rakhimgaliyev/vkrb/README.md

# vkrb
Выпускная квалификационная работа бакалавра
