rakhimgaliyev/vkrb/на печать/А3_НИР_d_26.pdf

# Ïàðåòî-ôðîíò îïòèìàëüíûõ ïàðàìåòðîâ êëàïàííîé ïðóæèíû ñ îãðàíè÷åíèì äèàìåòðà íàâèâêè ïðóæèíû d < 26 ìì

* Ñèíèì öâåòîì îáîçíà÷åíû âîçìîæíûå ðåøåíèÿ * Êðàñíûì - ôðîíò Ïàðåòî
* ×åðíûì - âûáðàííàÿ ïðóæèíà

Ðèñóíîê 3 - çàâèñèìîñòü êîëè÷åñòâà ðàáî÷èõ âèòêîâ îò êîýôôèöèåíòà çàïàñà

Ðèñóíîê 1 - çàâèñèìîñòü äëèíû ïðóæèíû â ñæàòîì ñîñòîÿíèè îò êîýôôèöèåíòà çàïàñà

Ðèñóíîê 2 - çàâèñèìîñòü ñðåäíåãî äèàìåòðà ïðóæèíû îò êîýôôèöèåíòà çàïàñà

# Ïàðåòî-ôðîíò îïòèìàëüíûõ ïàðàìåòðîâ êëàïàííîé ïðóæèíû ñ îãðàíè÷åíèì äèàìåòðà íàâèâêè ïðóæèíû d < 26 ìì

* Ñèíèì öâåòîì îáîçíà÷åíû âîçìîæíûå ðåøåíèÿ * Êðàñíûì - ôðîíò Ïàðåòî
* ×åðíûì - âûáðàííàÿ ïðóæèíà

Ðèñóíîê 3 - çàâèñèìîñòü êîëè÷åñòâà ðàáî÷èõ âèòêîâ îò êîýôôèöèåíòà çàïàñà

Ðèñóíîê 1 - çàâèñèìîñòü äëèíû ïðóæèíû â ñæàòîì ñîñòîÿíèè îò êîýôôèöèåíòà çàïàñà

Ðèñóíîê 2 - çàâèñèìîñòü ñðåäíåãî äèàìåòðà ïðóæèíû îò êîýôôèöèåíòà çàïàñà

КОМПАС-3D v18.1 Учебная версия © 2019 ООО "АСКОН-Системы проектирования", Россия. Все права защищены.
