rakhimgaliyev/vkrb/на печать/А3_НИР_Фронт_Парето.pdf

# Ïàðåòî-ôðîíò îïòèìàëüíûõ ïàðàìåòðîâ êëàïàííîé ïðóæèíû

# Ïàðåòî-ôðîíò îïòèìàëüíûõ ïàðàìåòðîâ êëàïàííîé ïðóæèíû

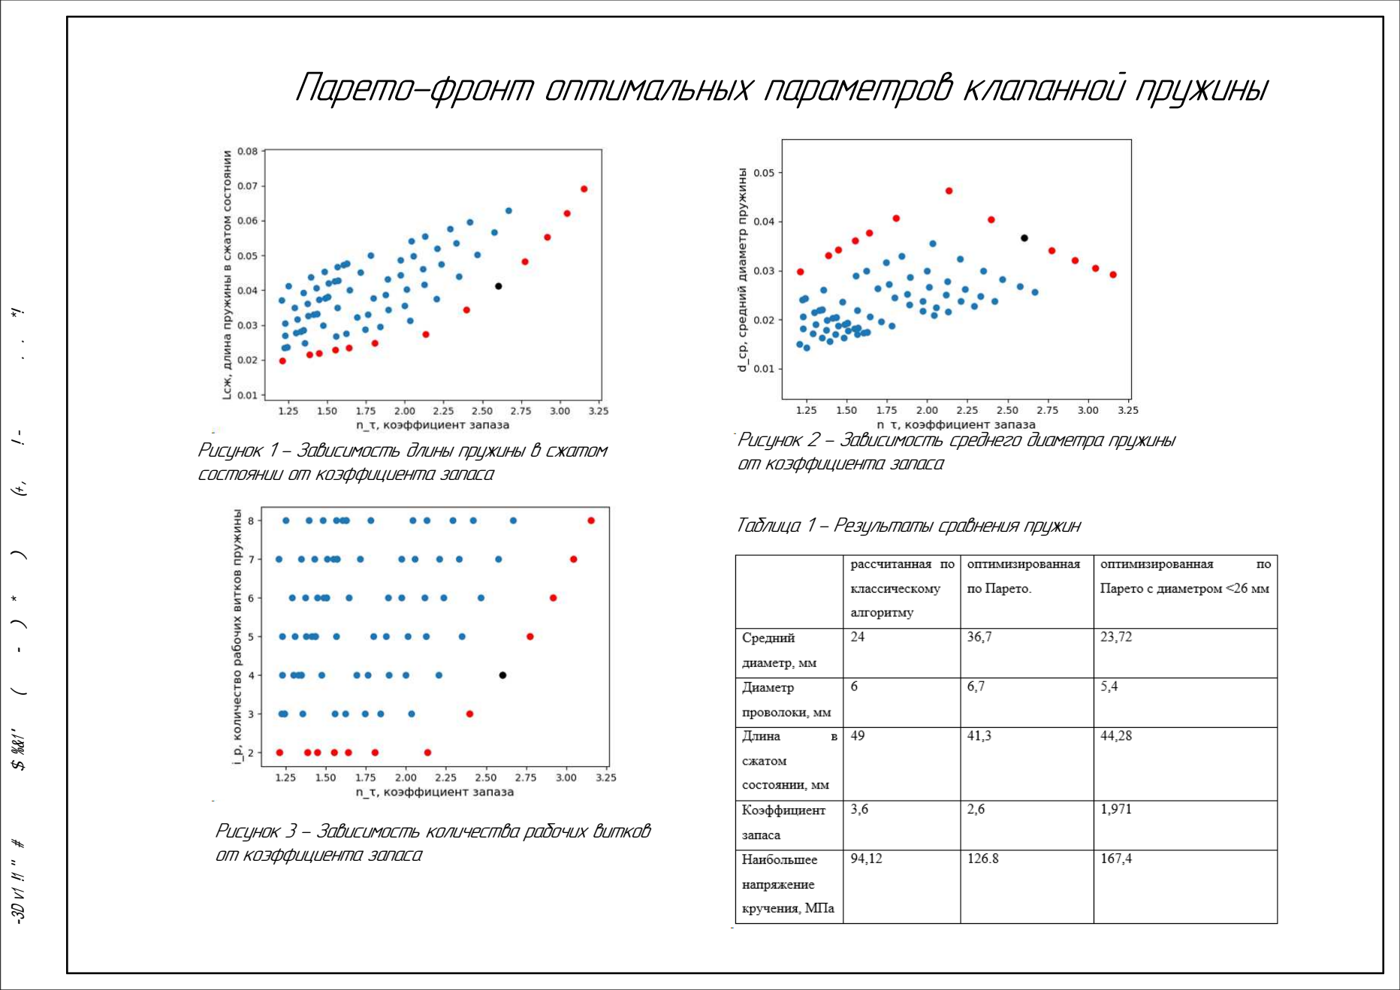
[picture p74: page 1]

Ðèñóíîê 3 - Çàâèñèìîñòü êîëè÷åñòâà ðàáî÷èõ âèòêîâ îò êîýôôèöèåíòà çàïàñà

Ðèñóíîê 1 - Çàâèñèìîñòü äëèíû ïðóæèíû â ñæàòîì ñîñòîÿíèè îò êîýôôèöèåíòà çàïàñà

Ðèñóíîê 2 - Çàâèñèìîñòü ñðåäíåãî äèàìåòðà ïðóæèíû îò êîýôôèöèåíòà çàïàñà

Òàáëèöà 1 - Ðåçóëüòàòû ñðàâíåíèÿ ïðóæèí

Ðèñóíîê 3 - Çàâèñèìîñòü êîëè÷åñòâà ðàáî÷èõ âèòêîâ îò êîýôôèöèåíòà çàïàñà

Ðèñóíîê 1 - Çàâèñèìîñòü äëèíû ïðóæèíû â ñæàòîì ñîñòîÿíèè îò êîýôôèöèåíòà çàïàñà

Ðèñóíîê 2 - Çàâèñèìîñòü ñðåäíåãî äèàìåòðà ïðóæèíû îò êîýôôèöèåíòà çàïàñà

Òàáëèöà 1 - Ðåçóëüòàòû ñðàâíåíèÿ ïðóæèí

КОМПАС-3D v18.1 Учебная версия © 2019 ООО "АСКОН-Системы проектирования", Россия. Все права защищены.
