rakhimgaliyev/vkrb/на печать/алгоритм оптимизации.pdf

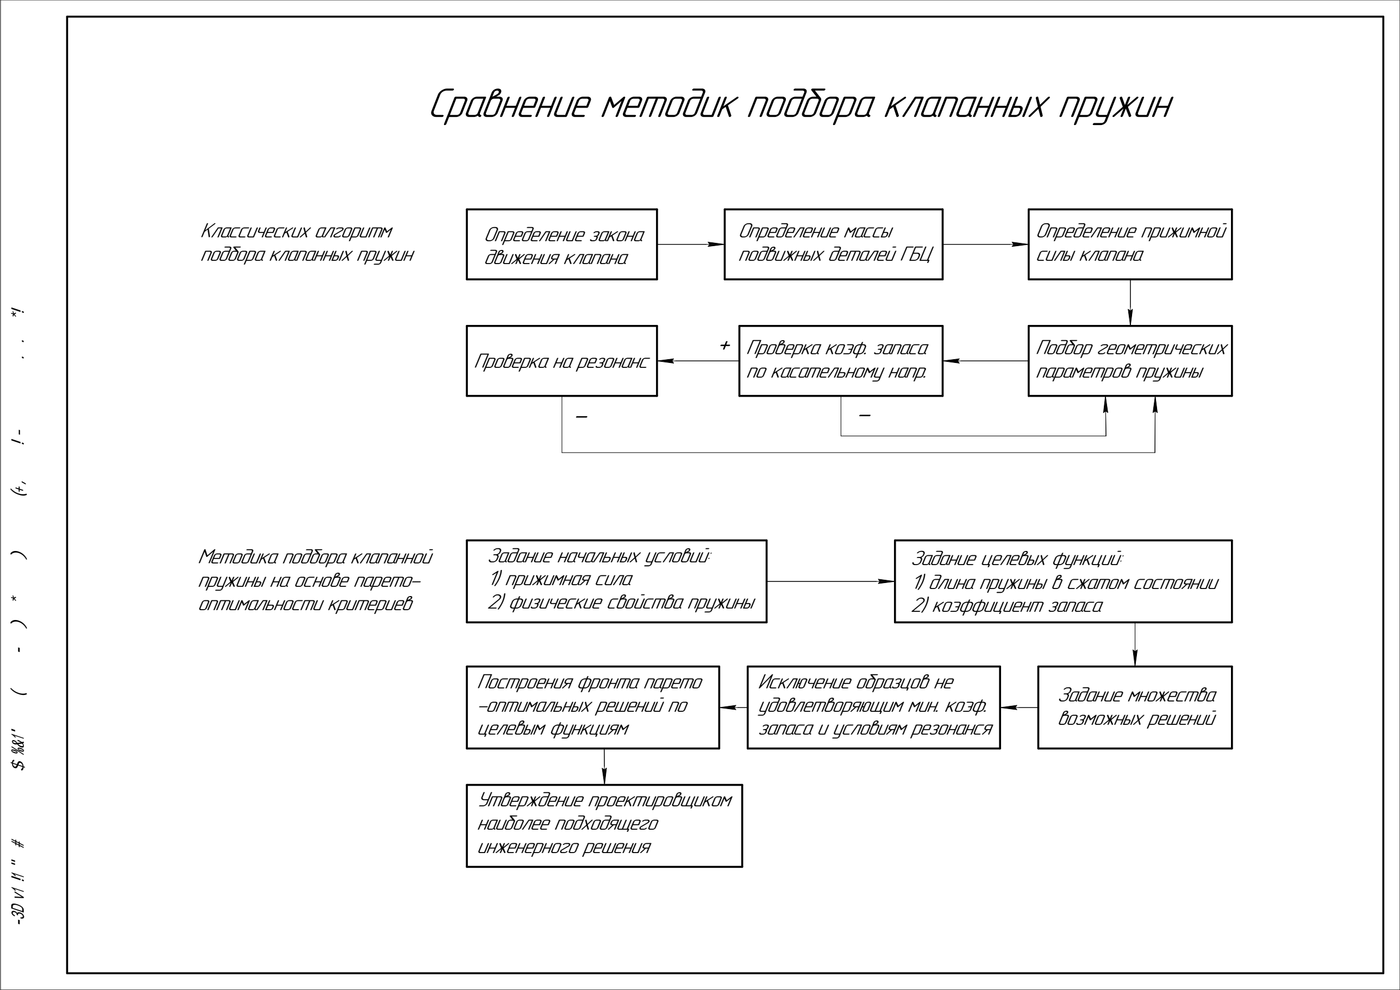
[picture p75: figure]
Çàäàíèå ìíîæåñòâà âîçìîæíûõ ðåøåíèé; Îïðåäåëåíèå çàêîíà äâèæåíèÿ êëàïàíà; Îïðåäåëåíèå ìàññû ïîäâèæíûõ äåòàëåé ÃÁÖ; Îïðåäåëåíèå ïðèæèìíîé ñèëû êëàïàíà; Êëàññè÷åñêèõ àëãîðèòì ïîäáîðà êëàïàííûõ ïðóæèí; Ìåòîäèêà ïîäáîðà êëàïàííîé ïðóæèíû íà îñíîâå ïàðåòî- îïòèìàëüíîñòè êðèòåðèåâ; Ïîäáîð ãåîìåòðè÷åñêèõ ïàðàìåòðîâ ïðóæèíû; Ïðîâåðêà êîýô. çàïàñà; - Çàäàíèå íà÷àëüíûõ óñëîâèé:; 1) ïðèæèìíàÿ ñèëà 2) ôèçè÷åñêèå ñâîéñòâà ïðóæèíû; Çàäàíèå öåëåâûõ ôóíêöèé: 1) äëèíà ïðóæèíû â ñæàòîì ñîñòîÿíèè 2) êîýôôèöèåíò çàïàñà; Èñêëþ÷åíèå îáðàçöîâ íå óäîâëåòâîðÿþùèì ìèí. êîýô. çàïàñà è óñëîâèÿì ðåçîíàíñÿ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

# Ñðàâíåíèå ìåòîäèê ïîäáîðà êëàïàííûõ ïðóæèí

ïî êàñàòåëüíîìó íàïð. Ïðîâåðêà íà ðåçîíàíñ

# Ñðàâíåíèå ìåòîäèê ïîäáîðà êëàïàííûõ ïðóæèí

ïî êàñàòåëüíîìó íàïð. Ïðîâåðêà íà ðåçîíàíñ

КОМПАС-3D v18.1 Учебная версия © 2019 ООО "АСКОН-Системы проектирования", Россия. Все права защищены.
