rakhimgaliyev/vkrb/на печать/10-А4_ЧБ_СПЕЦИФИКАЦИЯ.pdf

Âûïóñêíàÿ êâàëèôèêàöèîííàÿ ðàáîòà
Èçì. Ëèñò | | ¹ äîêóì. | Ïîäï. | Äàòà
| | Ðàçðàá. | Ðàõèìãàëèåâ | | Ñáîðêà áàëàíñèðíîãî âàëà | Ëèò. | Ëèñò | Ëèñòîâ
Ïðîâ. | Çåíêèí | | | | | | | 1

Í.êîíòð.
Óòâ.

ÌÃÒÓ èì. Í. Ý. Áàóìàíà
êàôåäðà Ý2
ãðóïïà Ý2-81Á

Èíâ. ¹ ïîäë. Ïîäï. è äàòà Âçàì. èíâ. ¹ Èíâ. ¹ äóáë. Ïîäï. è äàòà Ñïðàâ. ¹ Ïåðâ. ïðèìåí.
Äîêóìåíòàöèÿ

Ñáîðî÷íûé ÷åðòåæ

Äåòàëè

1 | Áàëàíñèðíûé âàë | 1
2 | Øåñòåðíÿ | 1

Ñòàíäàðòíûå èçäåëèÿ

3 | Ïîäøèïíèê 4024105 ÃÎÑÒ 4657-82 | 2
4 | Øàéáà ÃÎÑÒ 3248.5-16 | 1
5 | Áîëò Ì10õ40 ÃÎÑÒ 15589-70 | 1

Ôîðìàò
Çîíà
Ïîç.
Îáîçíà÷åíèå | Íàèìåíîâàíèå

Êîë.

Ïðèìå-
÷àíèå
Не для коммерческого использования | Êîïèðîâàë | Ôîðìàò | A4

КОМПАС-3D v18.1 Учебная версия © 2019 ООО "АСКОН-Системы проектирования", Россия. Все права защищены.
