rakhimgaliyev/vkrb/на печать/3_А1_ЦБ_КОЛЕНВАЛ.pdf

## Ðàñ÷åò íàïðÿæåííî-äåôîðìèðîâàííîãî ñîñòîÿíèÿ è çàïàñà öèêëè÷åñêîé ïðî÷íîñòè êîëåí÷àòîãî âàëà

Ãðàíè÷íûå óñëîâèÿ | Êîíå÷íî-ýëåìåíòíàÿ ìîäåëü ñáîðêè
Ïðè Zmax | Ïðè Zmin

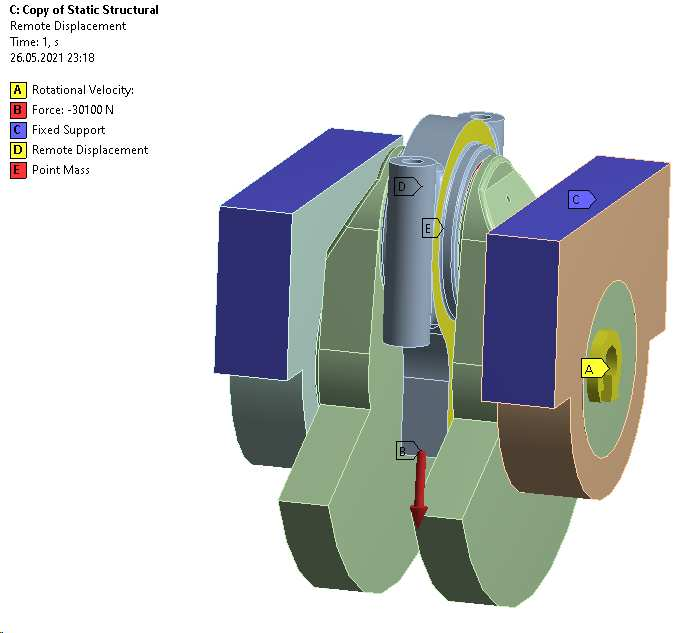
[picture p76: figure]
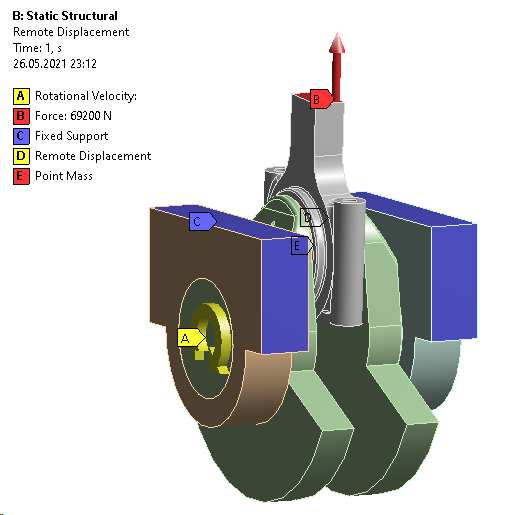
[picture p77: figure]

Ýêâèâàëåíòíûå íàïðÿæåíèÿ ïî Âàí-Ìåçèñó ïðè Zmax

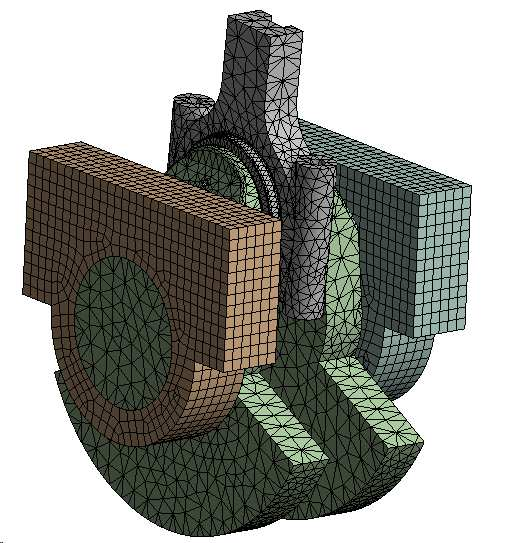
[picture p78: figure]

Ýêâèâàëåíòíûå íàïðÿæåíèÿ ïî Âàí-Ìåçèñó ïðè Zmin

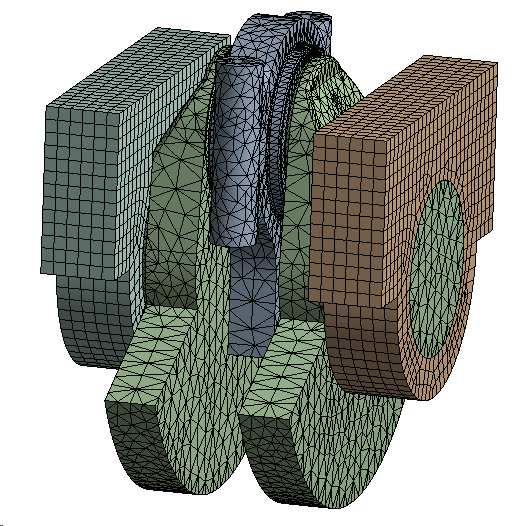
[picture p79: figure]

Ðàñïðåäåëåíèå êîýôèöèåíòà çàïàñà

Âû÷åñëåíèå êîýôèöèåíòà çàïàñà

n =

σ-1

σ1

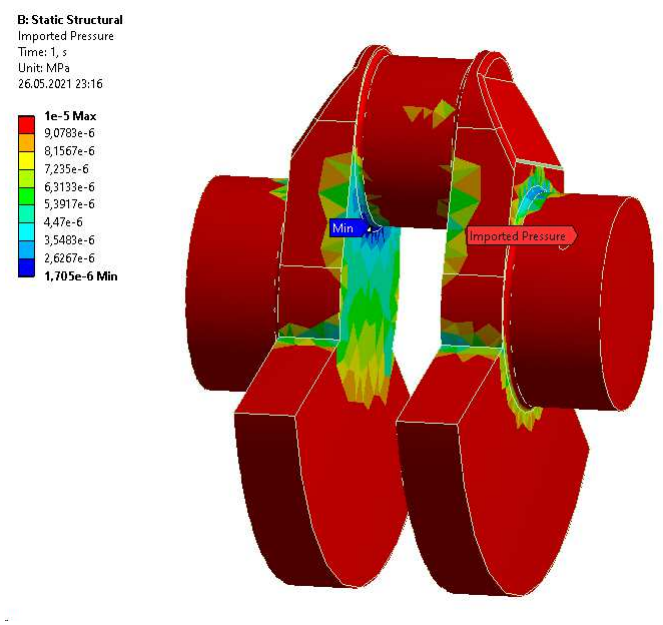
[picture p80: figure]
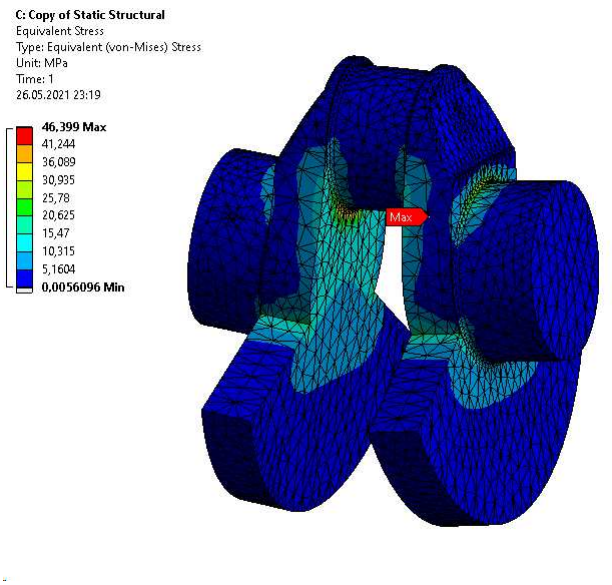
[picture p81: figure]
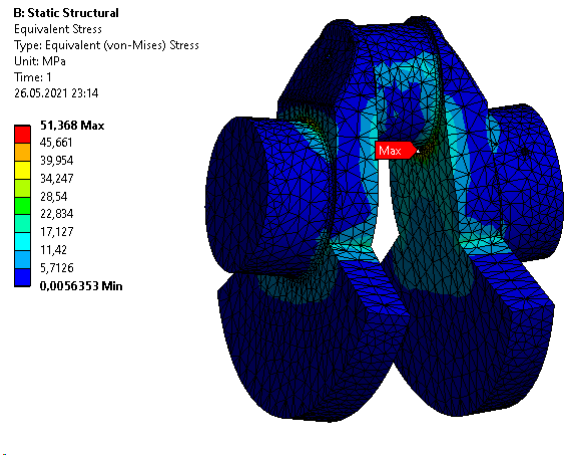
[picture p82: figure]

Âûâîä: Ìèíèìàëüíûé êîýôôèöèåíò çàïàñà n = 1,705. Ðàñ÷åò ïîêàçàë, ÷òî êîëåí÷àòûé âàë óäîâëåòâîðÿåò óñëîâèÿì ïðî÷íîñòè. Ìèíèìàëüíûé êîýôôèöèåíò çàïàñà ïðèíèìàåòñÿ èç äàïàçîíà 1,5 - 2,5.

## Ðàñ÷åò íàïðÿæåííî-äåôîðìèðîâàííîãî ñîñòîÿíèÿ è çàïàñà öèêëè÷åñêîé ïðî÷íîñòè êîëåí÷àòîãî âàëà

Ãðàíè÷íûå óñëîâèÿ | Êîíå÷íî-ýëåìåíòíàÿ ìîäåëü ñáîðêè
Ïðè Zmax | Ïðè Zmin

Ýêâèâàëåíòíûå íàïðÿæåíèÿ ïî Âàí-Ìåçèñó ïðè Zmax

Ýêâèâàëåíòíûå íàïðÿæåíèÿ ïî Âàí-Ìåçèñó ïðè Zmin

Ðàñïðåäåëåíèå êîýôèöèåíòà çàïàñà

Âû÷åñëåíèå êîýôèöèåíòà çàïàñà

n =

σ-1

σ1

Âûâîä: Ìèíèìàëüíûé êîýôôèöèåíò çàïàñà n = 1,705. Ðàñ÷åò ïîêàçàë, ÷òî êîëåí÷àòûé âàë óäîâëåòâîðÿåò óñëîâèÿì ïðî÷íîñòè. Ìèíèìàëüíûé êîýôôèöèåíò çàïàñà ïðèíèìàåòñÿ èç äàïàçîíà 1,5 - 2,5.

Í.êîíòð.
Óòâ.
| | | | Âûïóñêíàÿ êâàëèôèêàöèîííàÿ ðàáîòà
| | | | Ðàñ÷åò êîëåí÷àòîãî âàëà íà ïðî÷íîñòü | Ëèò. | Ìàññà | Ìàñøòàá
Èçì. Ëèñò | ¹ äîêóì. | Ïîäï. | Äàòà | | | | | 1:1
Ðàçðàá. | Ðàõèìãàëèåâ
Ïðîâ. | Çåíêèí
Ò.êîíòð. | | | | Ëèñò | Ëèñòîâ 1
| | | Äâèãàòåëü 4×Í 9,1/9,9 | ÌÃÒÓ èì. Í. Ý. Áàóìàíà êàôåäðà Ý2 Ãðóïïà Ý2-81á

Èíâ. ¹ ïîäë. Ïîäï. è äàòà Âçàì. èíâ. ¹ Èíâ. ¹ äóáë. Ïîäï. è äàòà Ñïðàâ. ¹ Ïåðâ. ïðèìåí.

Êîïèðîâàë | Ôîðìàò A1

КОМПАС-3D v18.1 Учебная версия © 2019 ООО "АСКОН-Системы проектирования", Россия. Все права защищены.
