rakhimgaliyev/vkrb/на печать/4_А1_ЦБ_ШАТУН_И_ПАЛЕЦ.pdf

# Ðàñ÷åò íàïðÿæåííî-äåôîðìèðîâàííîãî ñîñòîÿíèÿ

è

# çàïàñà öèêëè÷åñêîé ïðî÷íîñòè øàóòíà è ïîðøíåâîãî ïàëüöà

Ãðàíè÷íûå óñëîâèÿ | Êîíå÷íî-ýëåìåíòíàÿ ìîäåëü

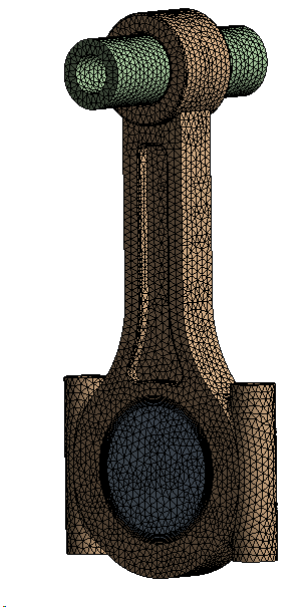
[picture p83: figure]

Ïðè Kmax | Ïðè Kmin

Ýêâèâàëåíòíûå íàïðÿæåíèÿ øàòóíà ïî Âàí-Ìåçèñó

Ïðè Kmax | Ïðè Kmin

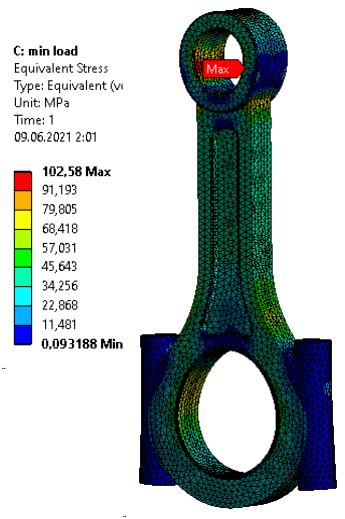
[picture p84: figure]
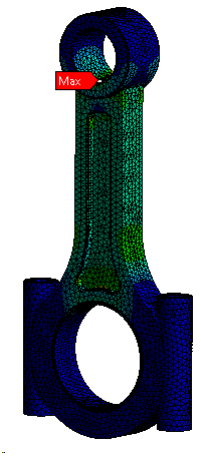
[picture p85: figure]
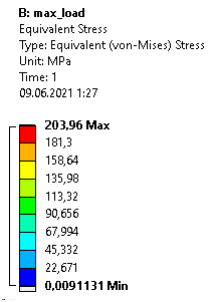
[picture p86: figure]

## Ðàñïðåäåëåíèå êîýôèöèåíòà çàïàñà

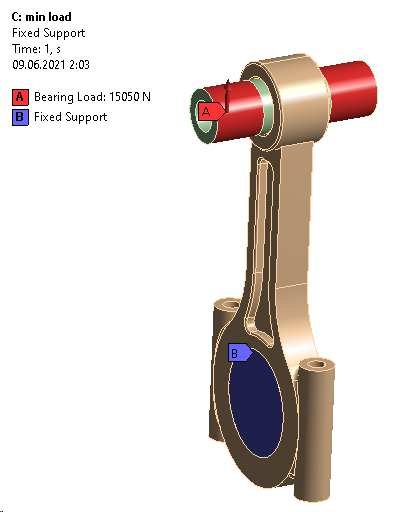
[picture p87: figure]
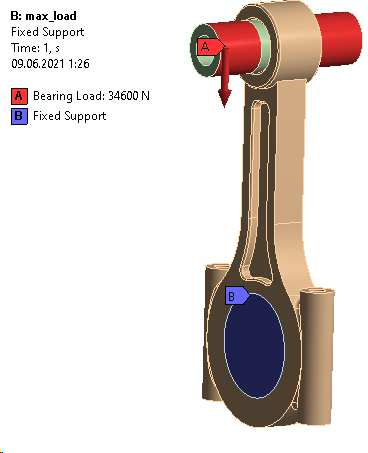
[picture p88: figure]

## Âû÷åñëåíèå êîýôèöèåíòà çàïàñà

n =

σ-1

σ1

## Ýêâèâàëåíòíûå íàïðÿæåíèÿ ïî Âàí-Ìåçèñó

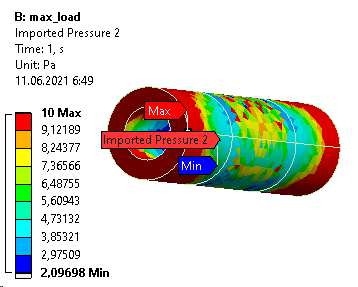
[picture p89: figure]

Ïðè Kmax | Ïðè Kmin

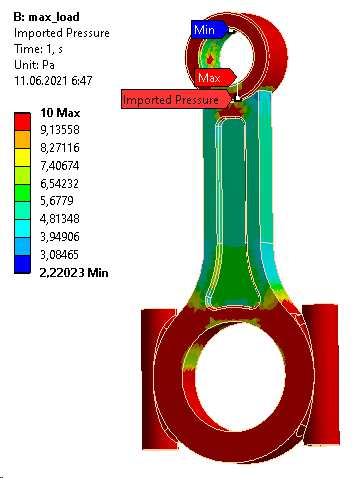
[picture p90: figure]
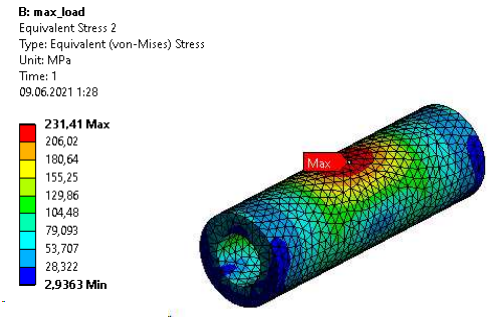
[picture p91: figure]
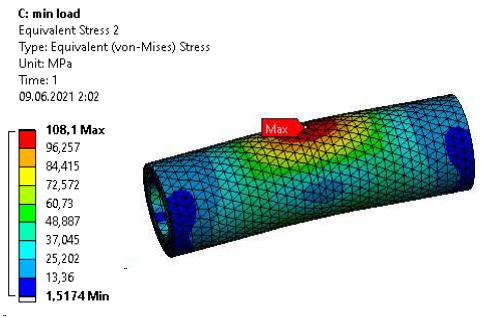
[picture p92: figure]

Âûâîä: Ìèíèìàëüíûé êîýôôèöèåíò çàïàñà øàòóíà n = 2,22, ïàëüöà n=2,1. Ïî çàïàñó öèêëè÷åñêîé ïðî÷íîñòè è ïî ìàêñèìàëüíûì íàïðÿæåíèÿì øàòóí è ïàëåö óäîâëåòâîðÿþò óñëîâèÿì ïðî÷íîñòè

# Ðàñ÷åò íàïðÿæåííî-äåôîðìèðîâàííîãî ñîñòîÿíèÿ

è

# çàïàñà öèêëè÷åñêîé ïðî÷íîñòè øàóòíà è ïîðøíåâîãî ïàëüöà

Ãðàíè÷íûå óñëîâèÿ | Êîíå÷íî-ýëåìåíòíàÿ ìîäåëü
Ïðè Kmax | Ïðè Kmin

Ýêâèâàëåíòíûå íàïðÿæåíèÿ øàòóíà ïî Âàí-Ìåçèñó

Ïðè Kmax | Ïðè Kmin

## Ðàñïðåäåëåíèå êîýôèöèåíòà çàïàñà

## Âû÷åñëåíèå êîýôèöèåíòà çàïàñà

n =

σ-1

σ1

## Ýêâèâàëåíòíûå íàïðÿæåíèÿ ïî Âàí-Ìåçèñó

Ïðè Kmax | Ïðè Kmin

Âûâîä: Ìèíèìàëüíûé êîýôôèöèåíò çàïàñà øàòóíà n = 2,22,
ïàëüöà n=2,1. Ïî çàïàñó öèêëè÷åñêîé ïðî÷íîñòè è ïî ìàêñèìàëüíûì
íàïðÿæåíèÿì øàòóí è ïàëåö óäîâëåòâîðÿþò óñëîâèÿì ïðî÷íîñòè | Ìàññà | Ìàñøòàá Èçì. Ëèñò | ¹ äîêóì. | Ïîäï. | Äàòà | Ëèò. Ðàçðàá.

Í.êîíòð.
Óòâ.

1:1
| Ðàõèìãàëèåâ
Ïðîâ. | Çåíêèí
Ò.êîíòð. | | | Ëèñò | Ëèñòîâ 1
| | Äâèãàòåëü 4×Í 9,1/9,9 | ÌÃÒÓ èì. Í. Ý. Áàóìàíà êàôåäðà Ý2 Ãðóïïà Ý2-81á
| Âûïóñêíàÿ êâàëèôèêàöèîííàÿ ðàáîòà
Ðàñ÷åò øàòóíà è ïîðøíåâîãî ïàëüöà íà ïðî÷íîñòü

Èíâ. ¹ ïîäë. Ïîäï. è äàòà Âçàì. èíâ. ¹ Èíâ. ¹ äóáë. Ïîäï. è äàòà Ñïðàâ. ¹ Ïåðâ. ïðèìåí.

Êîïèðîâàë | Ôîðìàò A1

КОМПАС-3D v18.1 Учебная версия © 2019 ООО "АСКОН-Системы проектирования", Россия. Все права защищены.
