rakhimgaliyev/vkrb/Mitsubishi MC - Engine 4D56 (1994 and subsequent). 1995-page-002.jpg

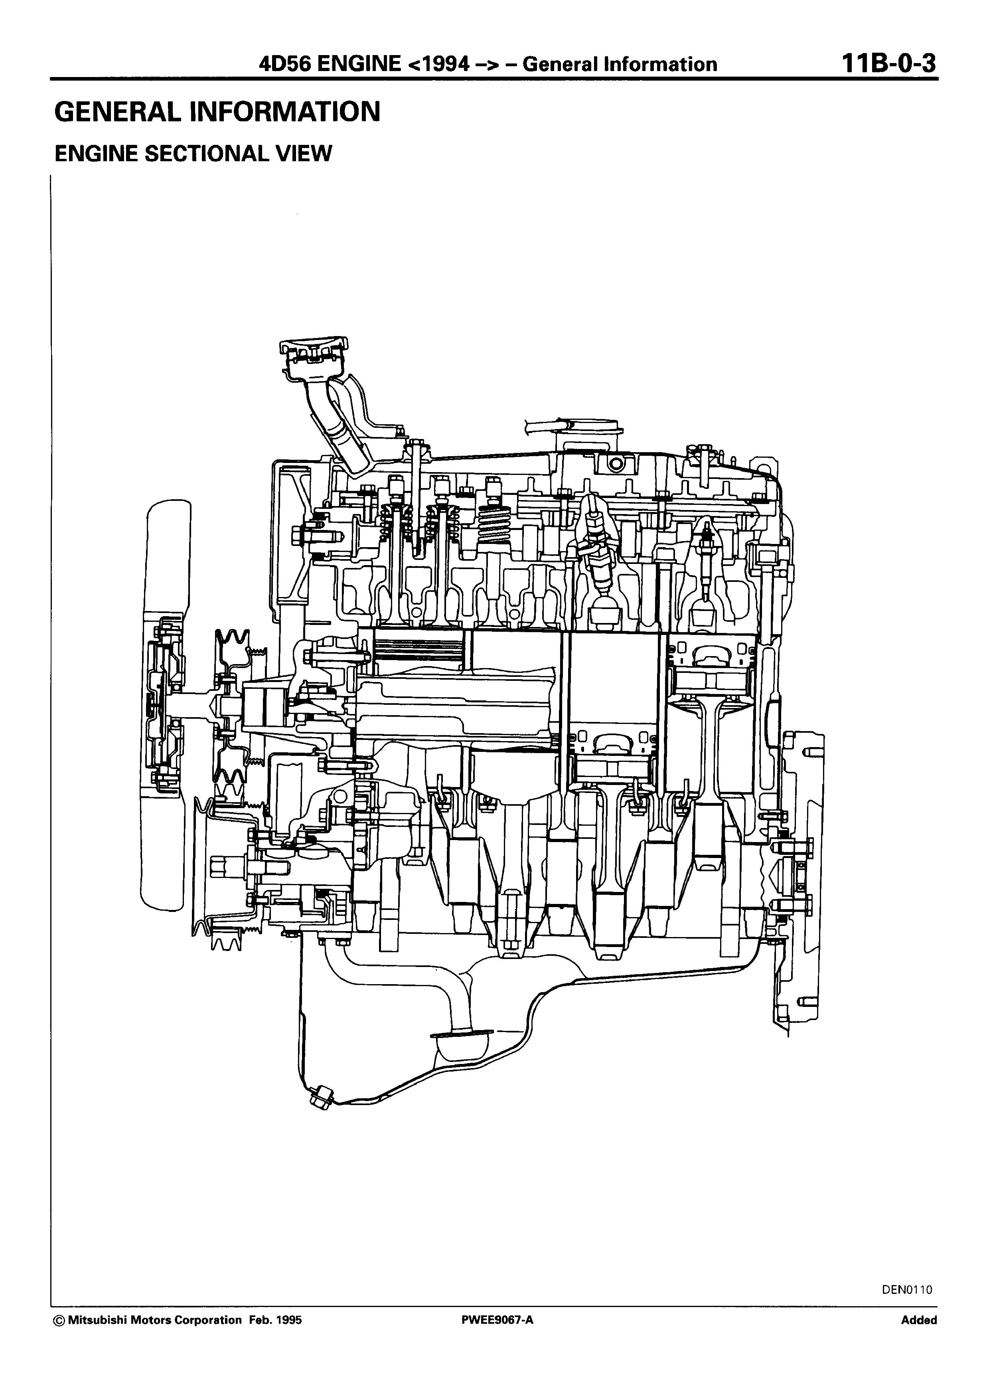
Mitsubishi MC - Engine 4D56 (1994 and subsequent). 1995-page-002.jpg
