rakhimgaliyev/vkrb/поршень/piston.igs

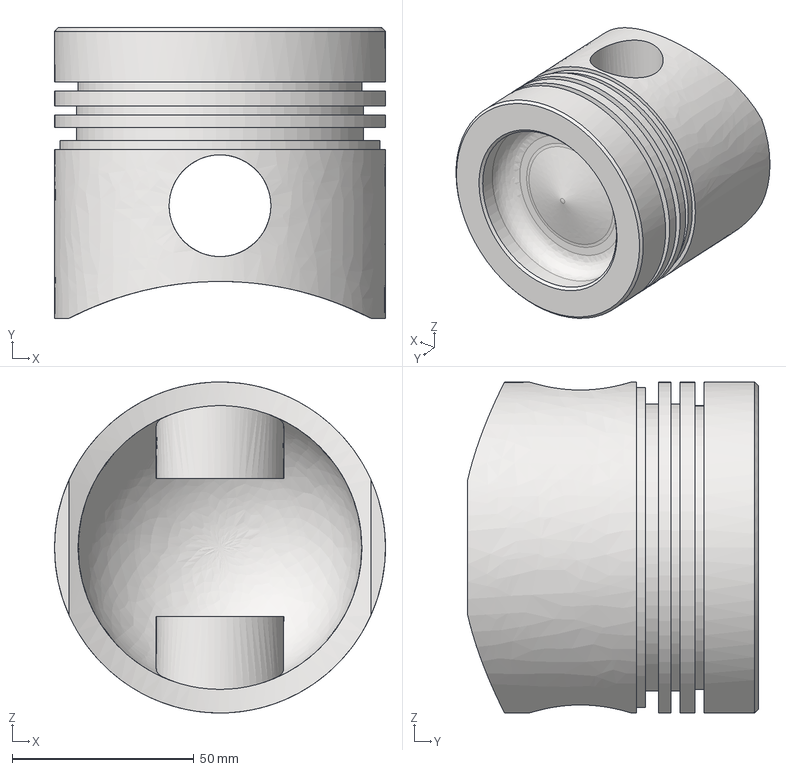
[picture p95: CAD file, 2021-06-11]
поршень/piston.igs
91.1 x 80.0 x 91.1 mm
