rakhimgaliyev/vkrb/расчет пружины/кулачек.SLDPRT

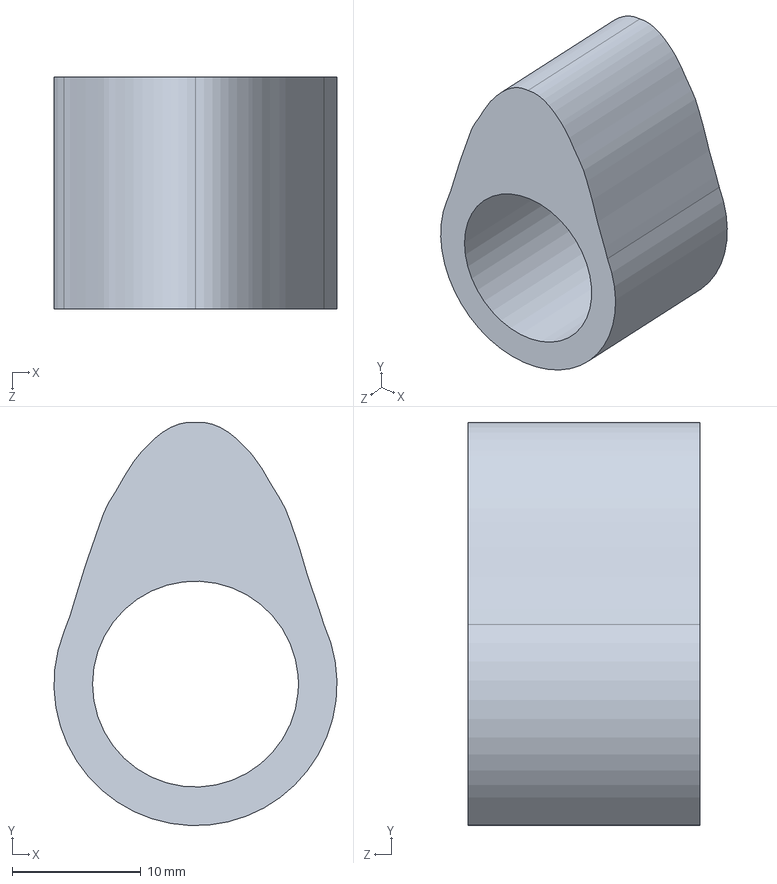
[picture p96: CAD file, 2021-06-06]
расчет пружины/кулачек.SLDPRT
22.0 x 31.3 x 18.0 mm
