rakhimgaliyev/vkrb/расчет пружины/клапан.SLDPRT

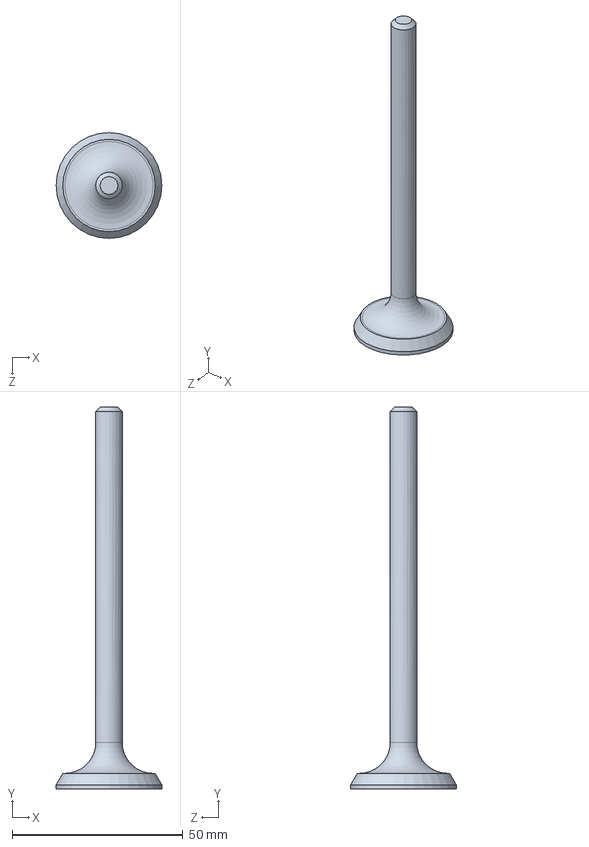
[picture p97: CAD file, 2021-06-06]
расчет пружины/клапан.SLDPRT
31.0 x 112.0 x 31.0 mm
