rakhimgaliyev/vkrb/сборка/сборка_балансирного_вала.igs

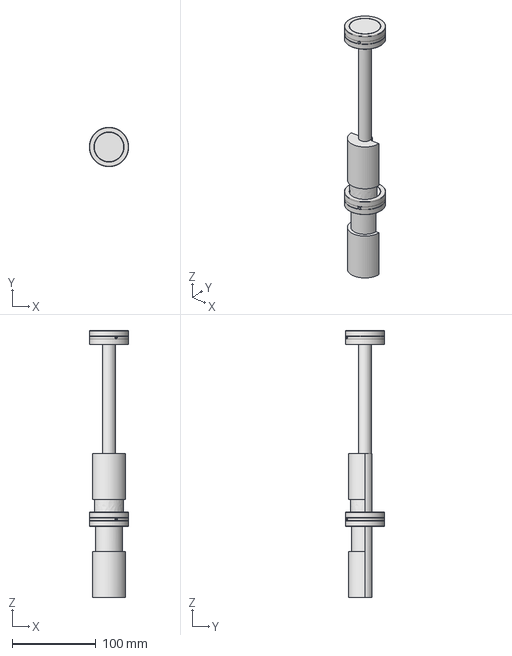
[picture p98: CAD file, 2021-06-16]
сборка/сборка_балансирного_вала.igs
47.0 x 47.0 x 319.0 mm
