rakhimgaliyev/vkrb/расчет пружины/гидрокомпенсатор.SLDPRT

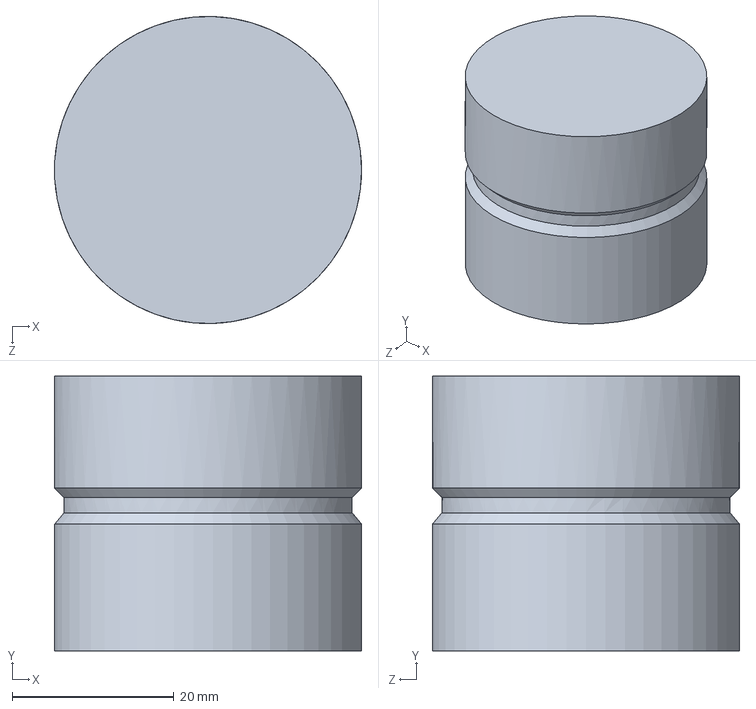
[picture p99: CAD file, 2021-06-06]
расчет пружины/гидрокомпенсатор.SLDPRT
38.0 x 34.0 x 38.0 mm
