rakhimgaliyev/vkrb/сборка/балансирный_вал.igs

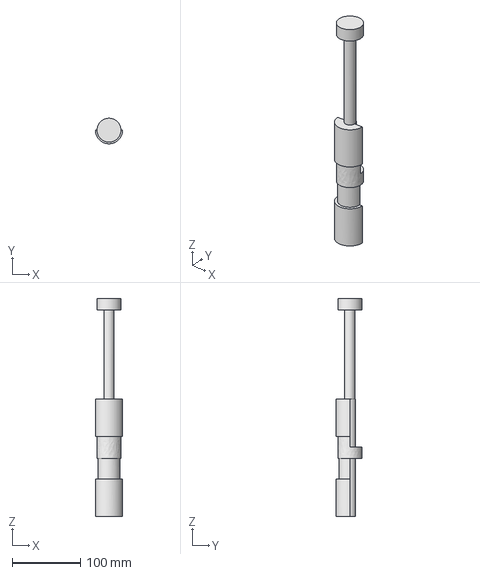
[picture p100: CAD file, 2021-06-16]
сборка/балансирный_вал.igs
40.0 x 37.5 x 319.0 mm
