rakhimgaliyev/vkrb/(list of files, cad)

Other CAD files:
balancing_scheme.dwg
сборка/Сборка-1.dwg
OldVersions/balancing_scheme.0019.dwg
сборка/OldVersions/Сборка-1.0007.dwg
поршень/piston.dwg
поршень/piston.idw
сборка/OldVersions/crankshaft.0019.ipt
сборка/OldVersions/Сборка.0011.iam
сборка/OldVersions/балансирный_вал.0006.ipt
сборка/OldVersions/поршень_шатун_палец.0001.iam
сборка/OldVersions/сборка_балансирного_вала.0003.iam
сборка/connecting_rod.ipt
сборка/crankshaft.ipt
сборка/pin.ipt
сборка/piston.ipt
сборка/Сборка.iam
сборка/Сборка/Мастер проектирования/OldVersions/Цилиндрическое зубчатое зацепление22.0001.ipt
сборка/Сборка/Мастер проектирования/Зубчатый ремень1.ipt
сборка/Сборка/Мастер проектирования/Зубчатый ремень2.ipt
сборка/Сборка/Мастер проектирования/Зубчатый ремень3.ipt
сборка/Сборка/Мастер проектирования/Зубчатый ремень4.ipt
сборка/Сборка/Мастер проектирования/Зубчатый ремень5.ipt
сборка/Сборка/Мастер проектирования/Зубчатый ремень6.ipt
сборка/Сборка/Мастер проектирования/Зубчатый ремень7.ipt
сборка/Сборка/Мастер проектирования/Зубчатый ремень8.ipt
сборка/Сборка/Мастер проектирования/Зубчатый ремень9.ipt
сборка/Сборка/Мастер проектирования/Передача с помощью зубчатых ремней1.iam
сборка/Сборка/Мастер проектирования/Передача с помощью зубчатых ремней2.iam
сборка/Сборка/Мастер проектирования/Передача с помощью зубчатых ремней3.iam
сборка/Сборка/Мастер проектирования/Передача с помощью зубчатых ремней4.iam
сборка/Сборка/Мастер проектирования/Передача с помощью зубчатых ремней5.iam
сборка/Сборка/Мастер проектирования/Передача с помощью зубчатых ремней6.iam
сборка/Сборка/Мастер проектирования/Передача с помощью зубчатых ремней7.iam
сборка/Сборка/Мастер проектирования/Передача с помощью зубчатых ремней8.iam
сборка/Сборка/Мастер проектирования/Передача с помощью зубчатых ремней9.iam
сборка/Сборка/Мастер проектирования/Синхронный шкив11.ipt
сборка/Сборка/Мастер проектирования/Синхронный шкив12.ipt
сборка/Сборка/Мастер проектирования/Синхронный шкив13.ipt
сборка/Сборка/Мастер проектирования/Синхронный шкив14.ipt
сборка/Сборка/Мастер проектирования/Синхронный шкив15.ipt
сборка/Сборка/Мастер проектирования/Синхронный шкив16.ipt
сборка/Сборка/Мастер проектирования/Синхронный шкив17.ipt
сборка/Сборка/Мастер проектирования/Синхронный шкив18.ipt
сборка/Сборка/Мастер проектирования/Синхронный шкив21.ipt
сборка/Сборка/Мастер проектирования/Синхронный шкив22.ipt
сборка/Сборка/Мастер проектирования/Синхронный шкив23.ipt
сборка/Сборка/Мастер проектирования/Синхронный шкив24.ipt
сборка/Сборка/Мастер проектирования/Синхронный шкив25.ipt
сборка/Сборка/Мастер проектирования/Синхронный шкив26.ipt
сборка/Сборка/Мастер проектирования/Синхронный шкив27.ipt
сборка/Сборка/Мастер проектирования/Синхронный шкив28.ipt
сборка/Сборка/Мастер проектирования/Синхронный шкив29.ipt
сборка/Сборка/Мастер проектирования/Синхронный шкив31.ipt
сборка/Сборка/Мастер проектирования/Синхронный шкив32.ipt
сборка/Сборка/Мастер проектирования/Синхронный шкив33.ipt
сборка/Сборка/Мастер проектирования/Синхронный шкив34.ipt
сборка/Сборка/Мастер проектирования/Синхронный шкив35.ipt
сборка/Сборка/Мастер проектирования/Синхронный шкив36.ipt
сборка/Сборка/Мастер проектирования/Синхронный шкив37.ipt
сборка/Сборка/Мастер проектирования/Цилиндрическое зубчатое зацепление1.iam
сборка/Сборка/Мастер проектирования/Цилиндрическое зубчатое зацепление11.ipt
сборка/Сборка/Мастер проектирования/Цилиндрическое зубчатое зацепление12.ipt
сборка/Сборка/Мастер проектирования/Цилиндрическое зубчатое зацепление2.iam
сборка/Сборка/Мастер проектирования/Цилиндрическое зубчатое зацепление21.ipt
сборка/Сборка/Мастер проектирования/Цилиндрическое зубчатое зацепление22.ipt
сборка/балансирный_вал.ipt
сборка/поршень_шатун_палец.iam
сборка/сборка_балансирного_вала.iam
