rakhimgaliyev/vkrb/Презентация.pdf

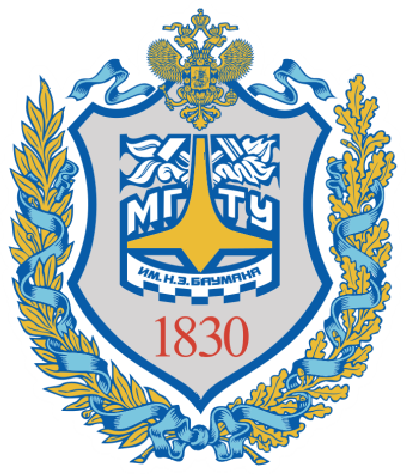
[picture p101: figure]

Выполнил: Рахимгалиев Т. Э2-81Б Руководитель: к.т.н., доцент кафедры Э2 Зенкин В. А.

ВКРБ на тему:
Автомобильный дизель 4ЧН9,1/9,5 мощностью 73 кВт при 4000 об/мин

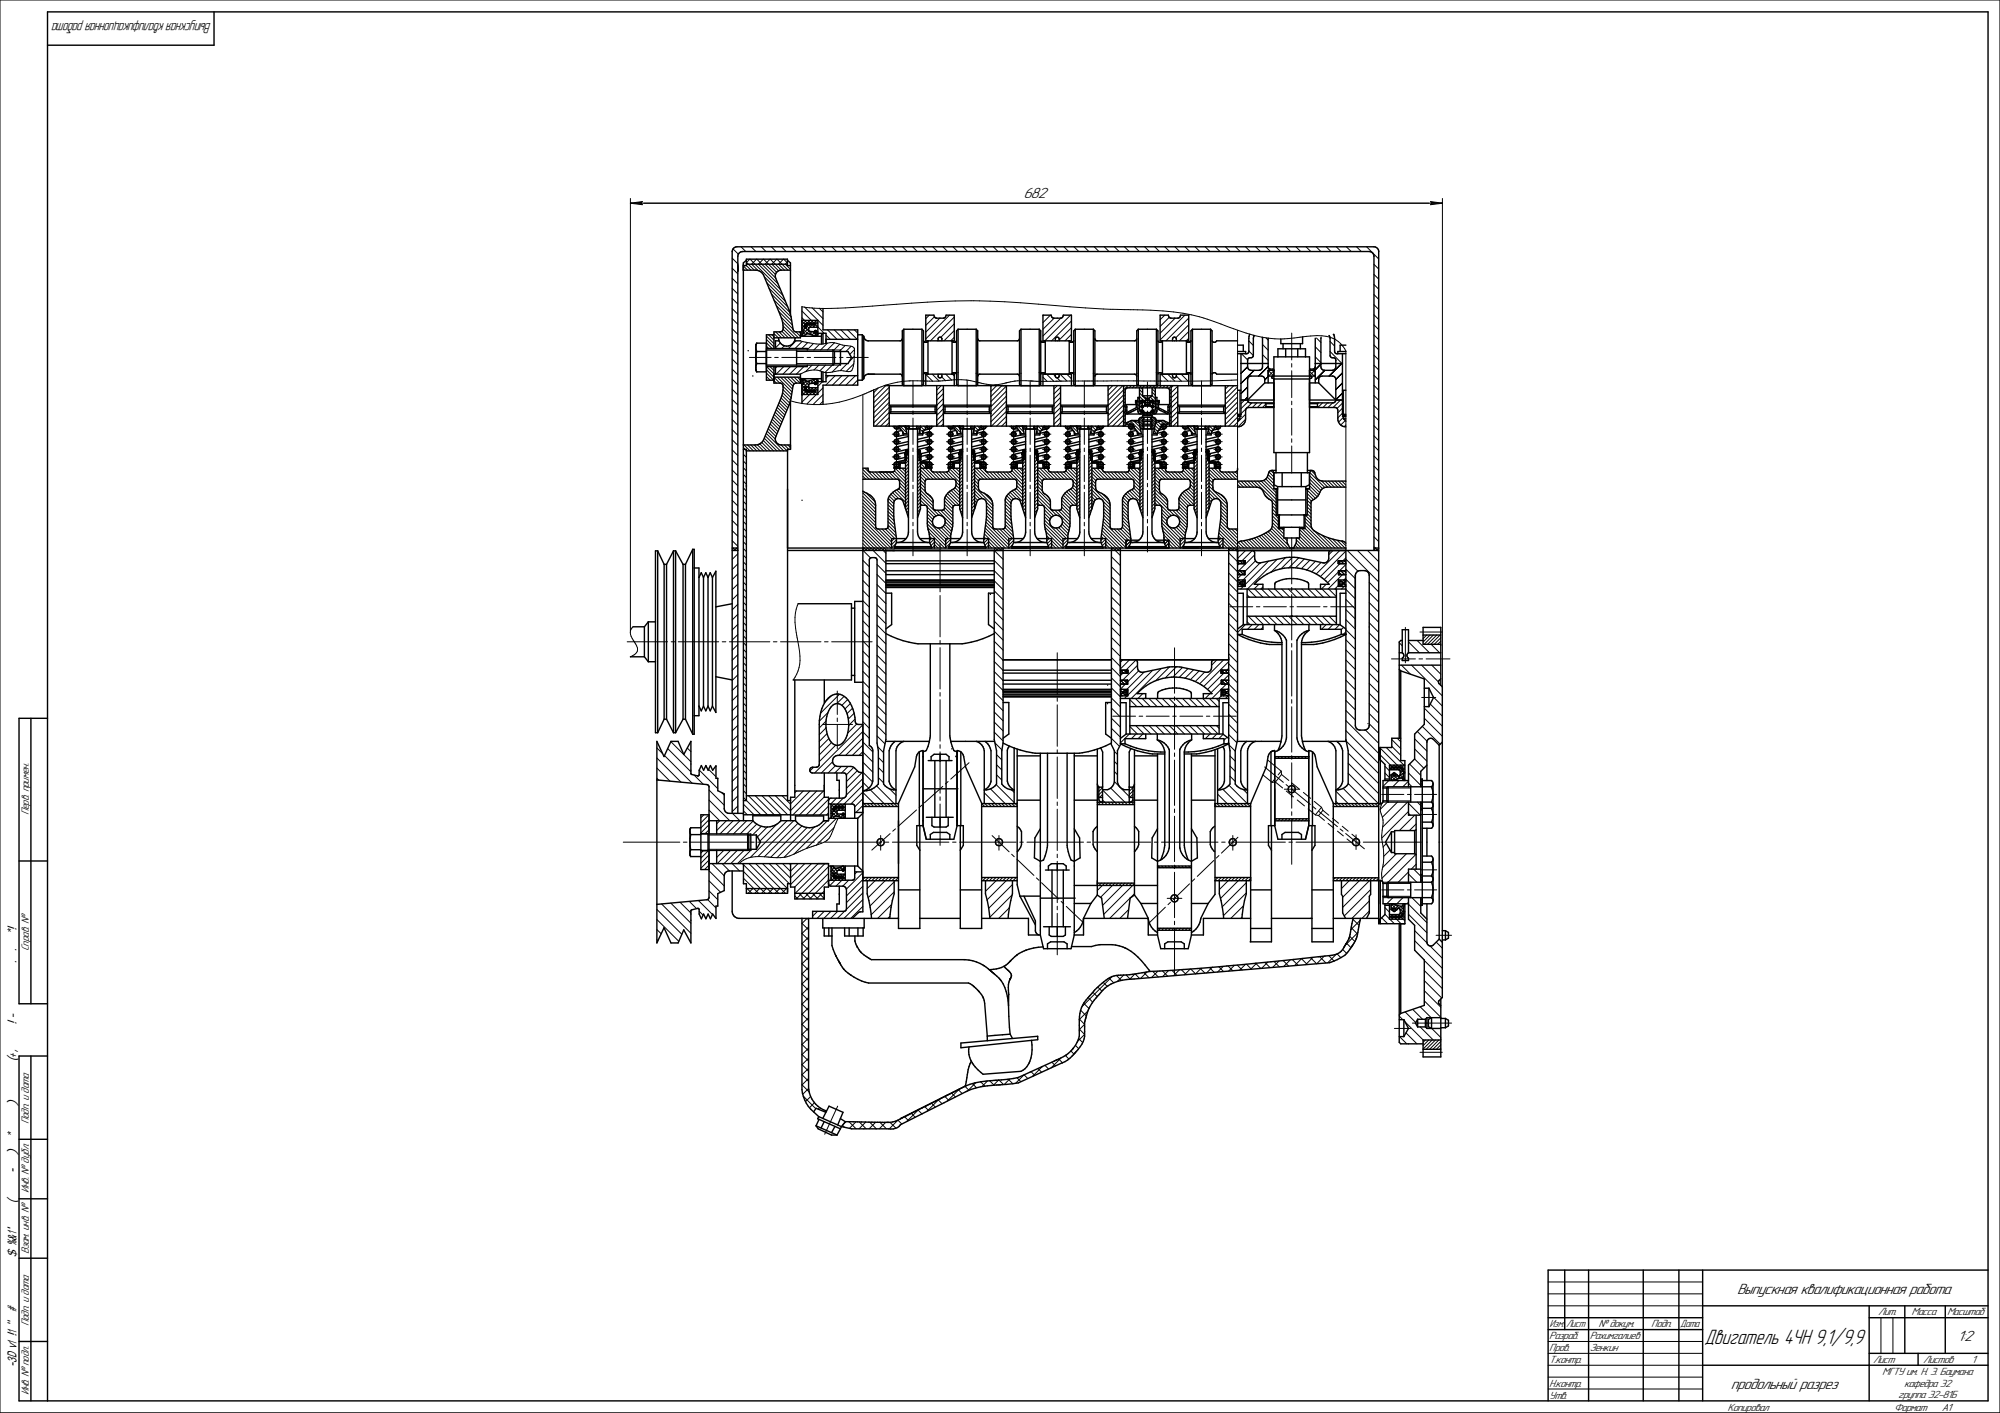
[picture p102: page 2]
Ìàññà Ìàñøòàá; Èçì. Ëèñò ¹ äîêóì.; Ïîäï. Äàòà; Ëèò.; Ðàçðàá. Ïðîâ.; Ò.êîíòð.; Ëèñò; Ëèñòîâ; Í.êîíòð. Óòâ.; Ðàõèìãàëèåâ; Äâèãàòåëü 4×Í 9,1/9,9 Çåíêèí; ïðîäîëüíûé ðàçðåç; Êîïèðîâàë; Ôîðìàò A1

Èíâ. ¹ ïîäë. Ïîäï. è äàòà Âçàì. èíâ. ¹ Èíâ. ¹ äóáë. Ïîäï. è äàòà Ñïðàâ. ¹ Ïåðâ. ïðèìåí.

КОМПАС-3D v18.1 Учебная версия © 2019 ООО "АСКОН-Системы проектирования", Россия. Все права защищены.

Âûïóñêíàÿ êâàëèôèêàöèîííàÿ ðàáîòà

ÌÃÒÓ èì. Í. Ý. Áàóìàíà
êàôåäðà Ý2
ãðóïïà Ý2-81Á

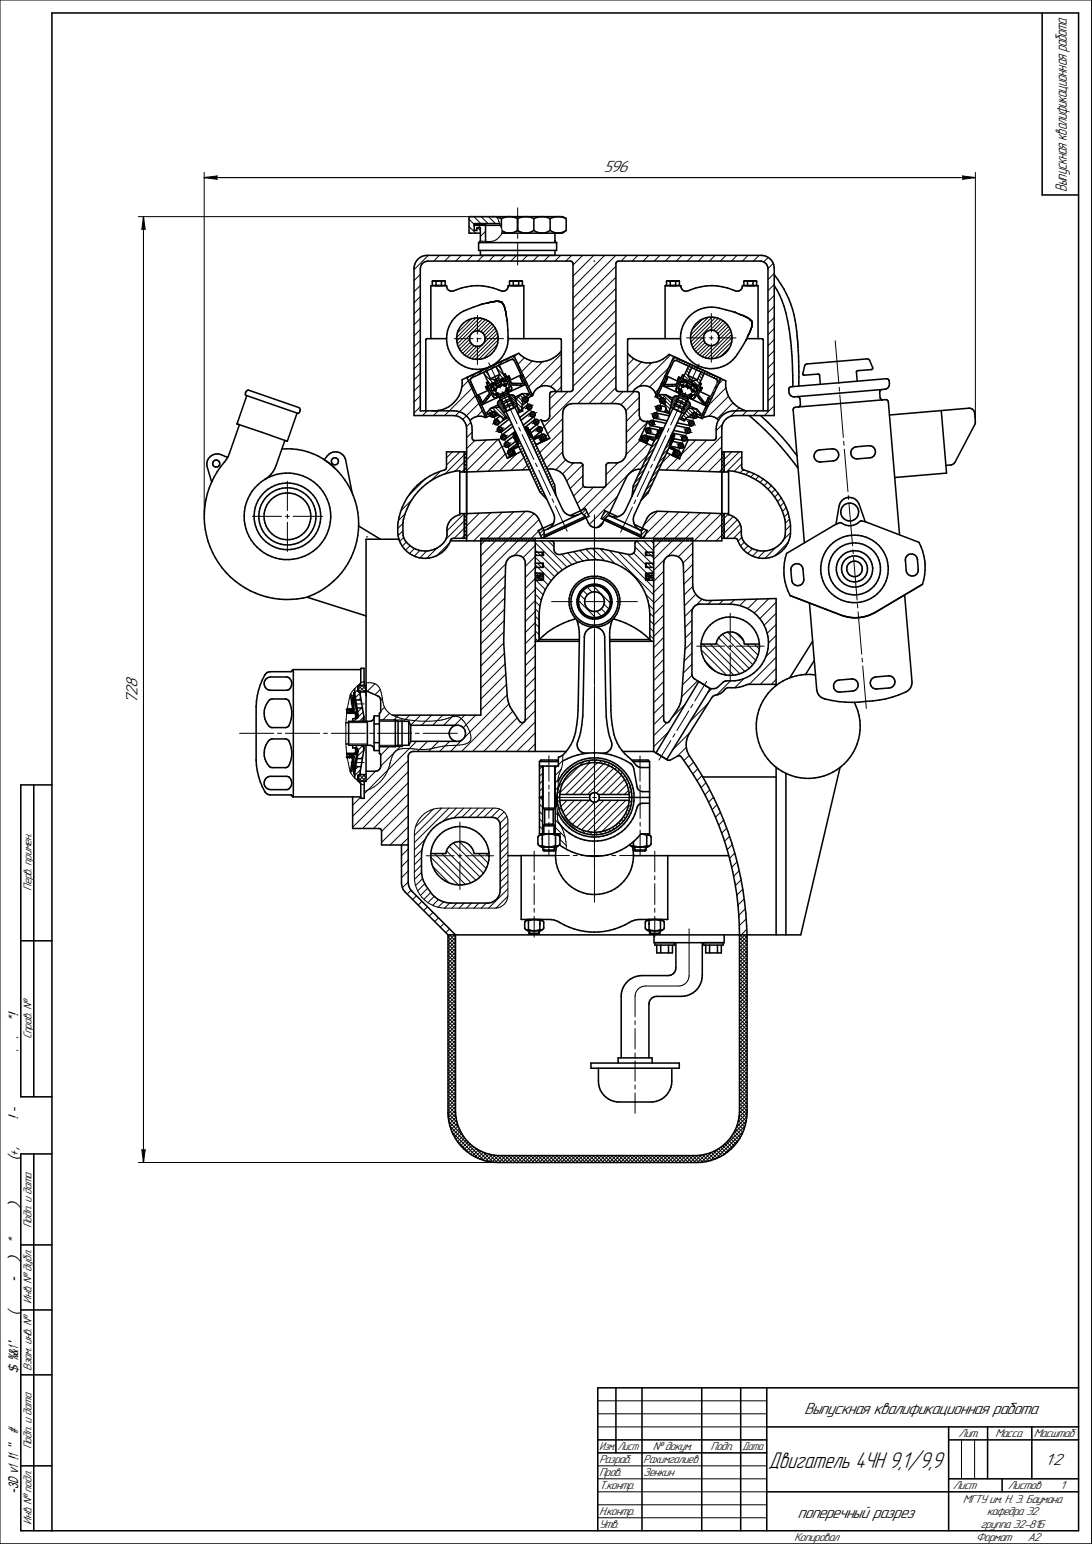
[picture p103: page 3]
Ìàññà Ìàñøòàá; Èçì. Ëèñò ¹ äîêóì.; Ïîäï. Äàòà; Ëèò.; Ðàçðàá.; Ðàõèìãàëèåâ; Äâèãàòåëü 4×Í 9,1/9,9; Çåíêèí; ãðóïïà Ý2-81Á; Êîïèðîâàë; Ôîðìàò

Âûïóñêíàÿ êâàëèôèêàöèîííàÿ ðàáîòà

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

КОМПАС-3D v18.1 Учебная версия © 2019 ООО "АСКОН-Системы проектирования", Россия. Все права защищены.

ïîïåðå÷íûé ðàçðåç

Не для коммерческого использования

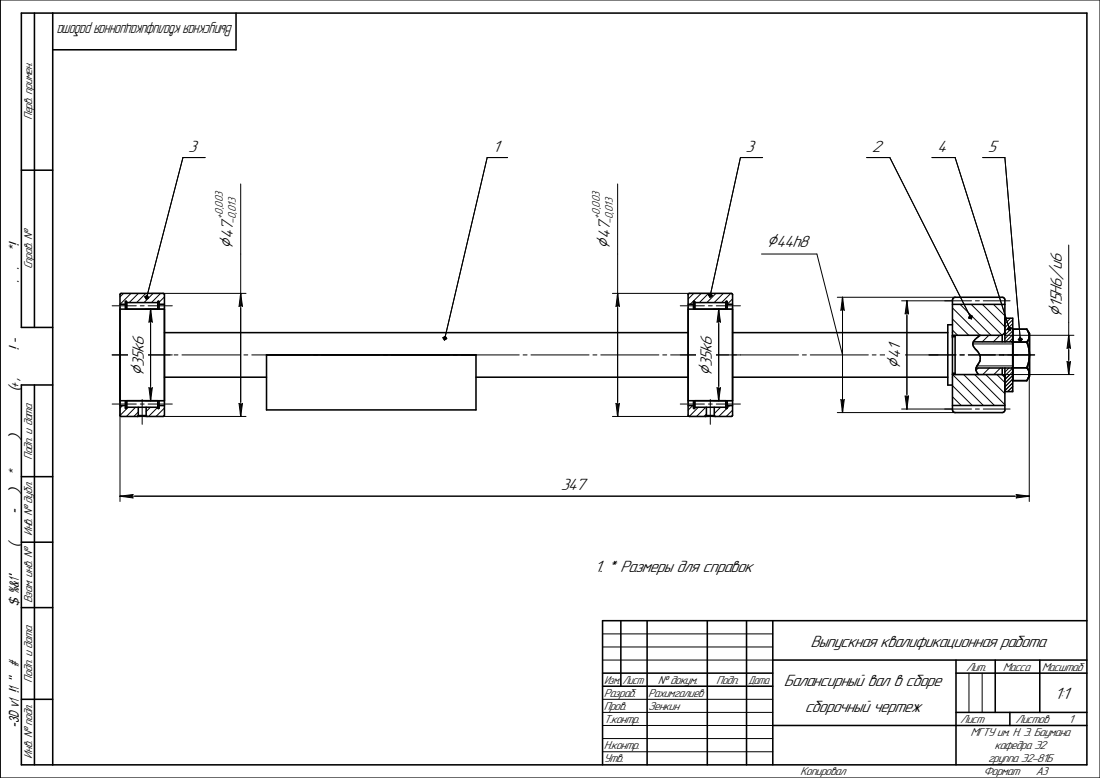
[picture p104: page 4]
ãðóïïà Ý2-81Á

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

КОМПАС-3D v18.1 Учебная версия © 2019 ООО "АСКОН-Системы проектирования", Россия. Все права защищены.

1. * Ðàçìåðû äëÿ ñïðàâîê

Âûïóñêíàÿ êâàëèôèêàöèîííàÿ ðàáîòà

Áàëàíñèðíûé âàë â ñáîðå ñáîðî÷íûé ÷åðòåæ | Ëèò. | Ìàññà | Ìàñøòàá

Èçì. Ëèñò | ¹ äîêóì. | Ïîäï. | Äàòà | | | | | 1:1
Ðàçðàá. | Ðàõèìãàëèåâ
Ïðîâ. | Çåíêèí

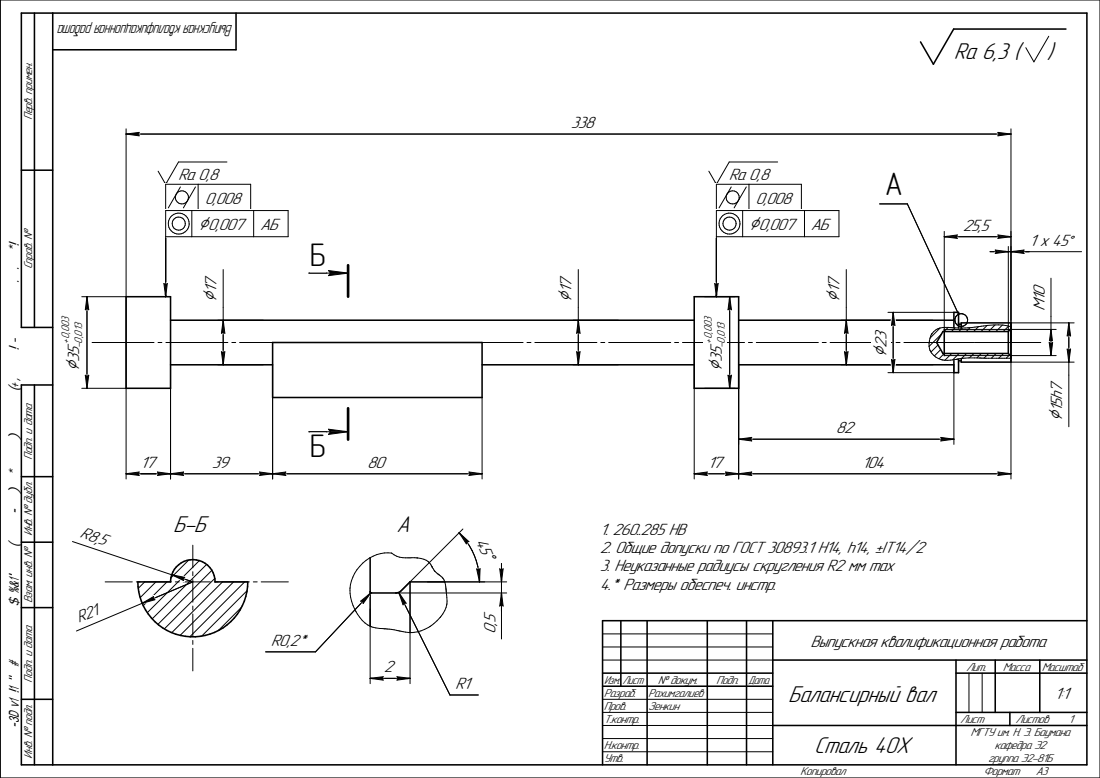
[picture p105: page 5]
Ñòàëü 40Õ; ãðóïïà Ý2-81Á

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

КОМПАС-3D v18.1 Учебная версия © 2019 ООО "АСКОН-Системы проектирования", Россия. Все права защищены.

2. Îáùèå äîïóñêè ïî ÃÎÑÒ 30893.1 H14, h14, ±IT14/2
3. Íåóêàçàííûå ðàäèóñû ñêðóãëåíèÿ R2 ìì max
4.* Ðàçìåðû îáåñïå÷. èíñòð.

Âûïóñêíàÿ êâàëèôèêàöèîííàÿ ðàáîòà

Áàëàíñèðíûé âàë | Ëèò. | Ìàññà | Ìàñøòàá

Èçì. Ëèñò | ¹ äîêóì. | Ïîäï. | Äàòà | | | | | 1:1
Ðàçðàá. | Ðàõèìãàëèåâ
Ïðîâ. | Çåíêèí

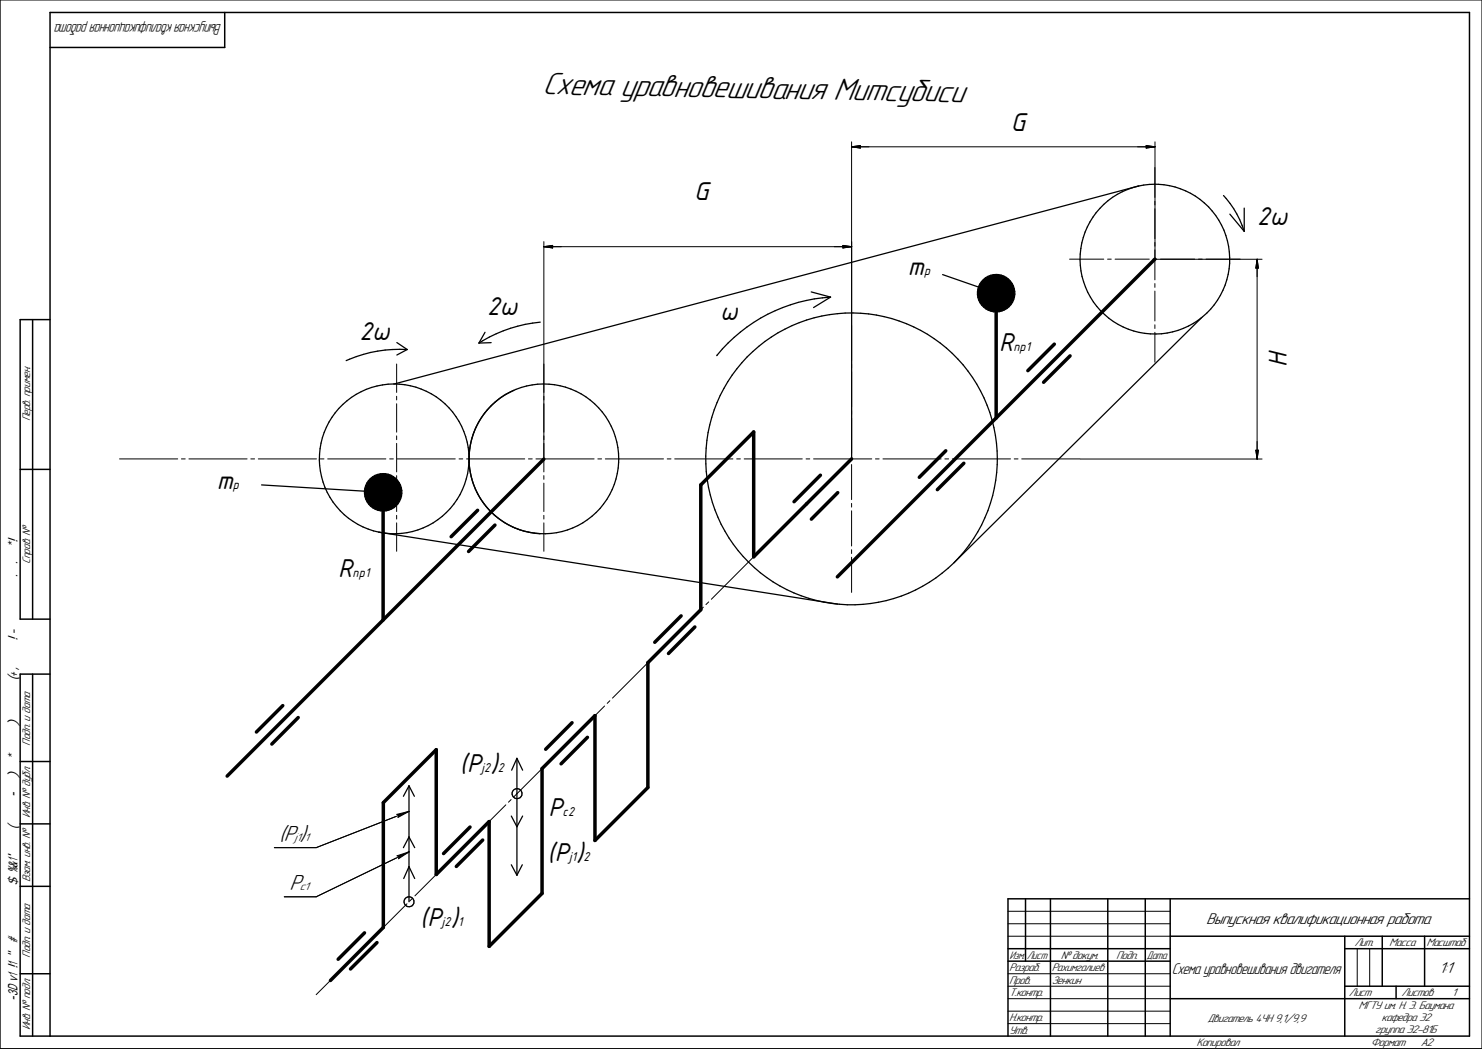
[picture p106: page 6]
Rпр1; Ñõåìà óðàâíîâåøèâàíèÿ Ìèòñóáèñè; Äâèãàòåëü 4×Í 9,1/9,9; ãðóïïà Ý2-81Á; Êîïèðîâàë; Ôîðìàò

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

КОМПАС-3D v18.1 Учебная версия © 2019 ООО "АСКОН-Системы проектирования", Россия. Все права защищены.

Âûïóñêíàÿ êâàëèôèêàöèîííàÿ ðàáîòà

Ëèò. | Ìàññà | Ìàñøòàá

Èçì. Ëèñò | ¹ äîêóì. | Ïîäï. | Äàòà | | | | | 1:1
Ðàçðàá. | Ðàõèìãàëèåâ | | | Ñõåìà óðàâíîâåøèâàíèÿ äâèãàòåëÿ Çåíêèí

Трехмерная модель сборки коленчатого вала,

## шатунно-поршневой группы и балансирных валов

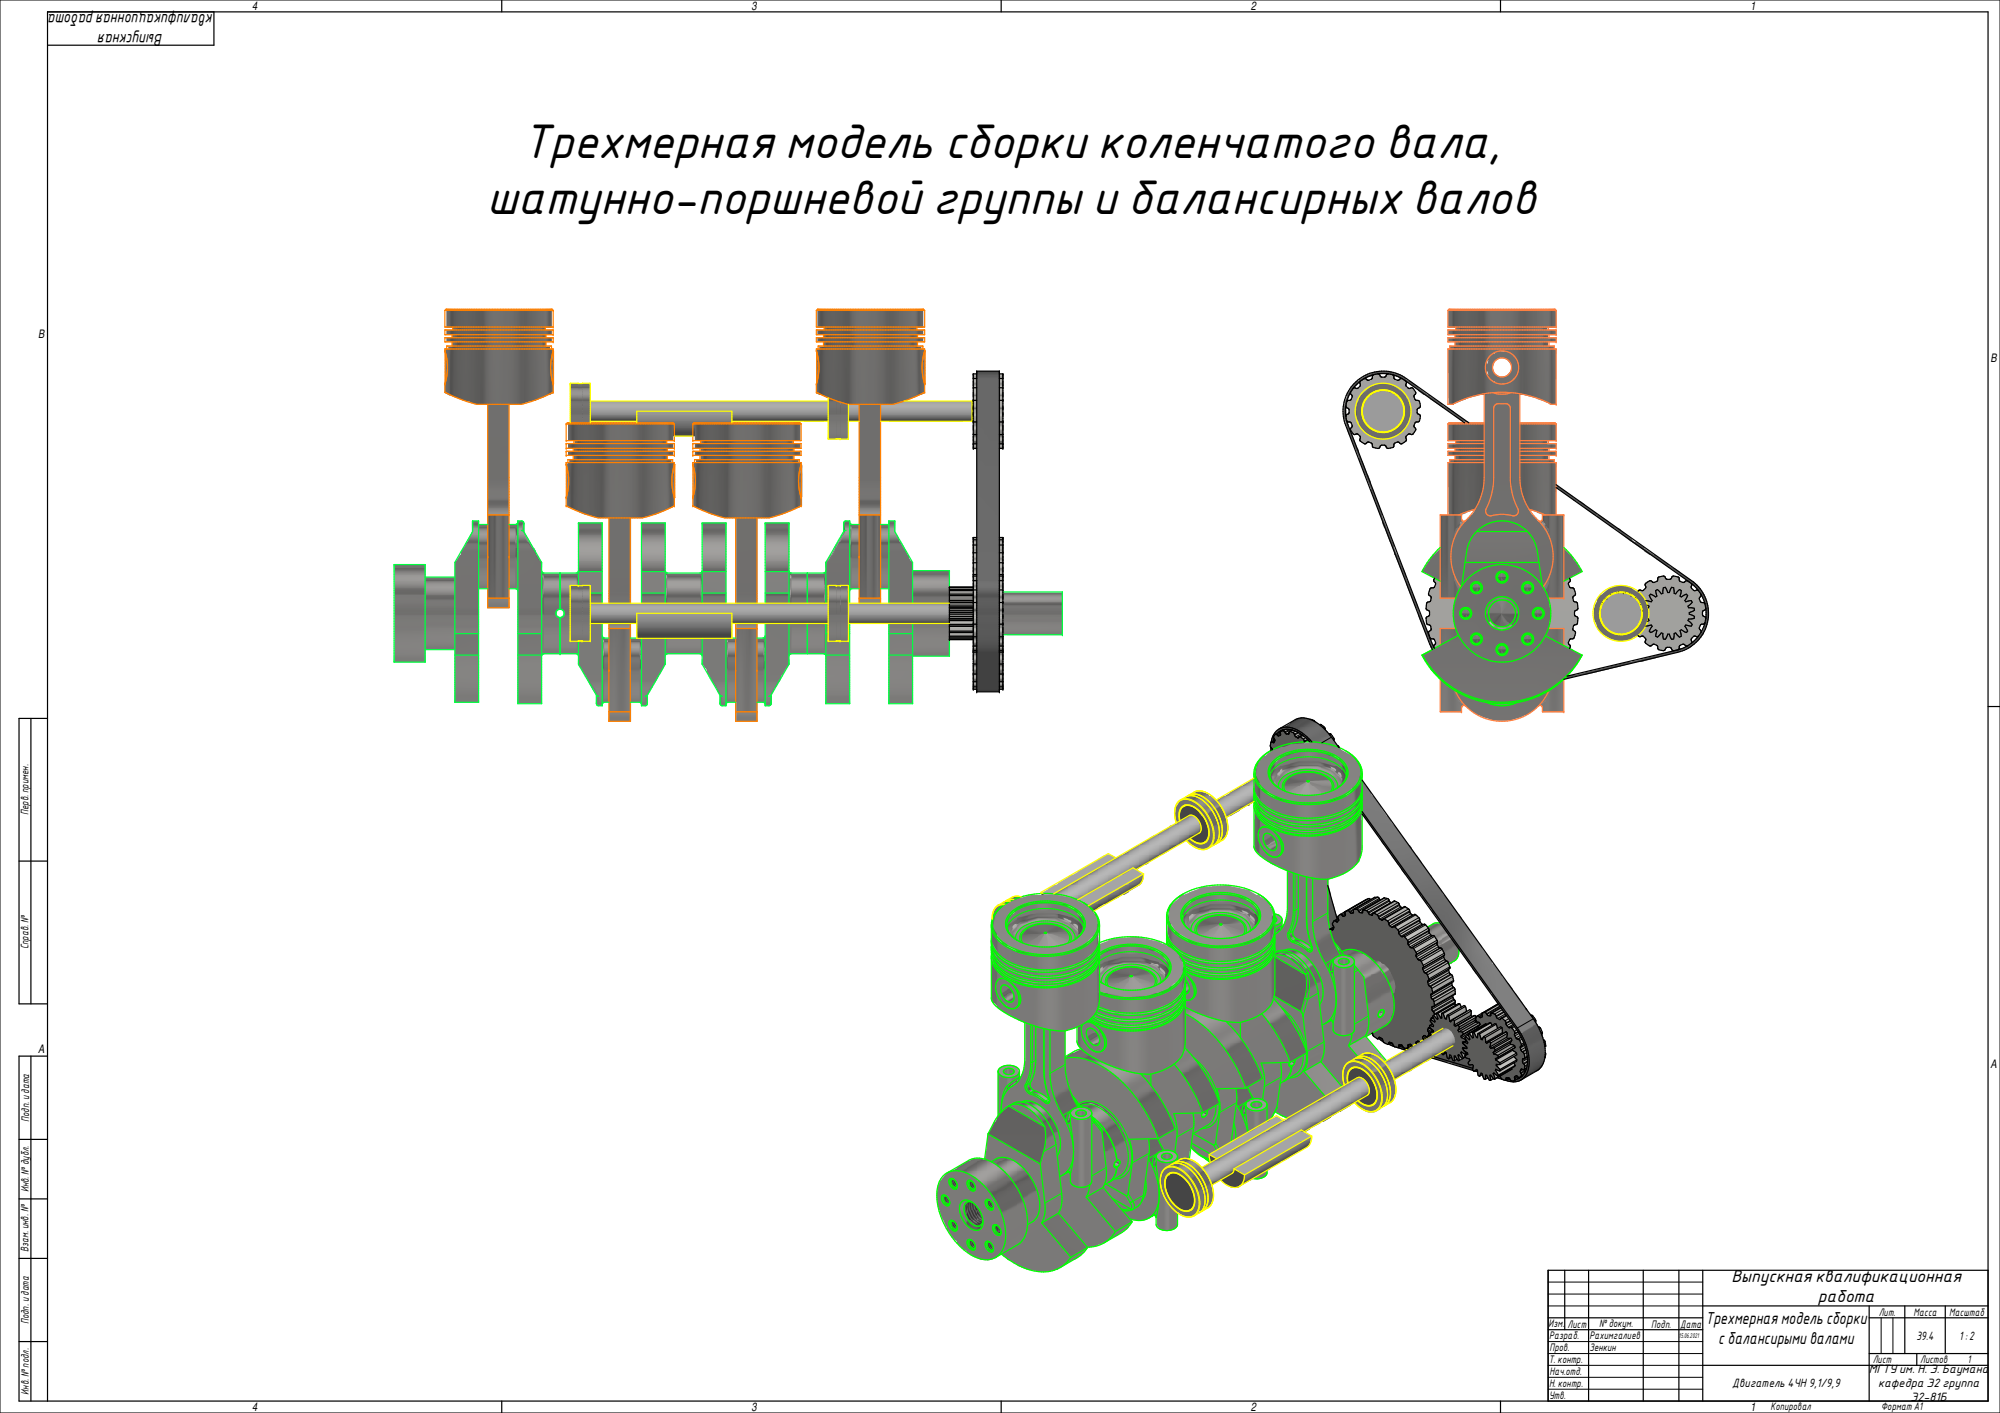
[picture p107: page 7]
Изм. Лист; № докум.; Подп. Дата; Разраб. Пров. Т. контр.; Н. контр. Утв.; Лит.; Масса; Масштаб; Лист; Листов; Нач.отд.; Рахимгалиев Зенкин; Выпускная квалификационная работа; Двигатель 4ЧН 9,1/9,9; Копировал; Формат A1; н. яанксупыВ

Трехмерная модель сборки
с балансирыми валами

МГТУ им. Н. Э. Баумана
кафедра Э2 группа

# Ðàñ÷åò íàïðÿæåííî-äåôîðìèðîâàííîãî ñîñòîÿíèÿ è çàïàñà öèêëè÷åñêîé ïðî÷íîñòè êîëåí÷àòîãî âàëà

Ãðàíè÷íûå óñëîâèÿ | Êîíå÷íî-ýëåìåíòíàÿ ìîäåëü ñáîðêè
Ïðè Zmax | Ïðè Zmin

## Ýêâèâàëåíòíûå íàïðÿæåíèÿ ïî Âàí-Ìåçèñó ïðè Zmax

## Ýêâèâàëåíòíûå íàïðÿæåíèÿ ïî Âàí-Ìåçèñó ïðè Zmin

## Ðàñïðåäåëåíèå êîýôèöèåíòà çàïàñà

## Âû÷åñëåíèå êîýôèöèåíòà çàïàñà

n =

σ-1

σ1

Âûâîä: Ìèíèìàëüíûé êîýôôèöèåíò çàïàñà n = 1,705. Ðàñ÷åò ïîêàçàë, ÷òî êîëåí÷àòûé âàë óäîâëåòâîðÿåò óñëîâèÿì ïðî÷íîñòè. Ìèíèìàëüíûé êîýôôèöèåíò çàïàñà ïðèíèìàåòñÿ èç äàïàçîíà 1,5 - 2,5.

# Ðàñ÷åò íàïðÿæåííî-äåôîðìèðîâàííîãî ñîñòîÿíèÿ è çàïàñà öèêëè÷åñêîé ïðî÷íîñòè êîëåí÷àòîãî âàëà

Ãðàíè÷íûå óñëîâèÿ | Êîíå÷íî-ýëåìåíòíàÿ ìîäåëü ñáîðêè
Ïðè Zmax | Ïðè Zmin

## Ýêâèâàëåíòíûå íàïðÿæåíèÿ ïî Âàí-Ìåçèñó ïðè Zmax

## Ýêâèâàëåíòíûå íàïðÿæåíèÿ ïî Âàí-Ìåçèñó ïðè Zmin

## Ðàñïðåäåëåíèå êîýôèöèåíòà çàïàñà

## Âû÷åñëåíèå êîýôèöèåíòà çàïàñà

n =

σ-1

σ1

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

| | | | Âûïóñêíàÿ êâàëèôèêàöèîííàÿ ðàáîòà
| | | | Ðàñ÷åò êîëåí÷àòîãî âàëà íà ïðî÷íîñòü | Ëèò. | Ìàññà | Ìàñøòàá
Èçì. Ëèñò | ¹ äîêóì. | Ïîäï. | Äàòà | | | | | 1:1
Ðàçðàá. | Ðàõèìãàëèåâ
| Çåíêèí

Ãðóïïà Ý2-81á

Äâèãàòåëü 4×Í 9,1/9,9

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

КОМПАС-3D v18.1 Учебная версия © 2019 ООО "АСКОН-Системы проектирования", Россия. Все права защищены.

# Ðàñ÷åò íàïðÿæåííî-äåôîðìèðîâàííîãî ñîñòîÿíèÿ

è

# çàïàñà öèêëè÷åñêîé ïðî÷íîñòè øàóòíà è ïîðøíåâîãî ïàëüöà

Ãðàíè÷íûå óñëîâèÿ | Êîíå÷íî-ýëåìåíòíàÿ ìîäåëü


Ïðè Kmax | Ïðè Kmin

Ýêâèâàëåíòíûå íàïðÿæåíèÿ øàòóíà ïî Âàí-Ìåçèñó

Ïðè Kmax | Ïðè Kmin


## Ðàñïðåäåëåíèå êîýôèöèåíòà çàïàñà


## Âû÷åñëåíèå êîýôèöèåíòà çàïàñà

n =

σ-1

σ1

## Ýêâèâàëåíòíûå íàïðÿæåíèÿ ïî Âàí-Ìåçèñó


Ïðè Kmax | Ïðè Kmin


Âûâîä: Ìèíèìàëüíûé êîýôôèöèåíò çàïàñà øàòóíà n = 2,22, ïàëüöà n=2,1. Ïî çàïàñó öèêëè÷åñêîé ïðî÷íîñòè è ïî ìàêñèìàëüíûì íàïðÿæåíèÿì øàòóí è ïàëåö óäîâëåòâîðÿþò óñëîâèÿì ïðî÷íîñòè

# Ðàñ÷åò íàïðÿæåííî-äåôîðìèðîâàííîãî ñîñòîÿíèÿ

è

# çàïàñà öèêëè÷åñêîé ïðî÷íîñòè øàóòíà è ïîðøíåâîãî ïàëüöà

Ãðàíè÷íûå óñëîâèÿ | Êîíå÷íî-ýëåìåíòíàÿ ìîäåëü
Ïðè Kmax | Ïðè Kmin

Ýêâèâàëåíòíûå íàïðÿæåíèÿ øàòóíà ïî Âàí-Ìåçèñó

Ïðè Kmax | Ïðè Kmin

## Ðàñïðåäåëåíèå êîýôèöèåíòà çàïàñà

## Âû÷åñëåíèå êîýôèöèåíòà çàïàñà

n =

σ-1

σ1

## Ýêâèâàëåíòíûå íàïðÿæåíèÿ ïî Âàí-Ìåçèñó

Ïðè Kmax | Ïðè Kmin

Âûâîä: Ìèíèìàëüíûé êîýôôèöèåíò çàïàñà øàòóíà n = 2,22,
ïàëüöà n=2,1. Ïî çàïàñó öèêëè÷åñêîé ïðî÷íîñòè è ïî ìàêñèìàëüíûì
íàïðÿæåíèÿì øàòóí è ïàëåö óäîâëåòâîðÿþò óñëîâèÿì ïðî÷íîñòè | Ìàññà | Ìàñøòàá Èçì. Ëèñò | ¹ äîêóì. | Ïîäï. | Äàòà | Ëèò. Ðàçðàá.
1:1
Ðàõèìãàëèåâ
Çåíêèí
| Âûïóñêíàÿ êâàëèôèêàöèîííàÿ ðàáîòà
Ðàñ÷åò øàòóíà è ïîðøíåâîãî ïàëüöà íà ïðî÷íîñòü
Äâèãàòåëü 4×Í 9,1/9,9 | Ãðóïïà Ý2-81á

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

КОМПАС-3D v18.1 Учебная версия © 2019 ООО "АСКОН-Системы проектирования", Россия. Все права защищены.

# Ðàñ÷åò ïîðøíÿ

# Îïðåäåëåíèå òåïëîâîãî ñîñòîÿíèÿ

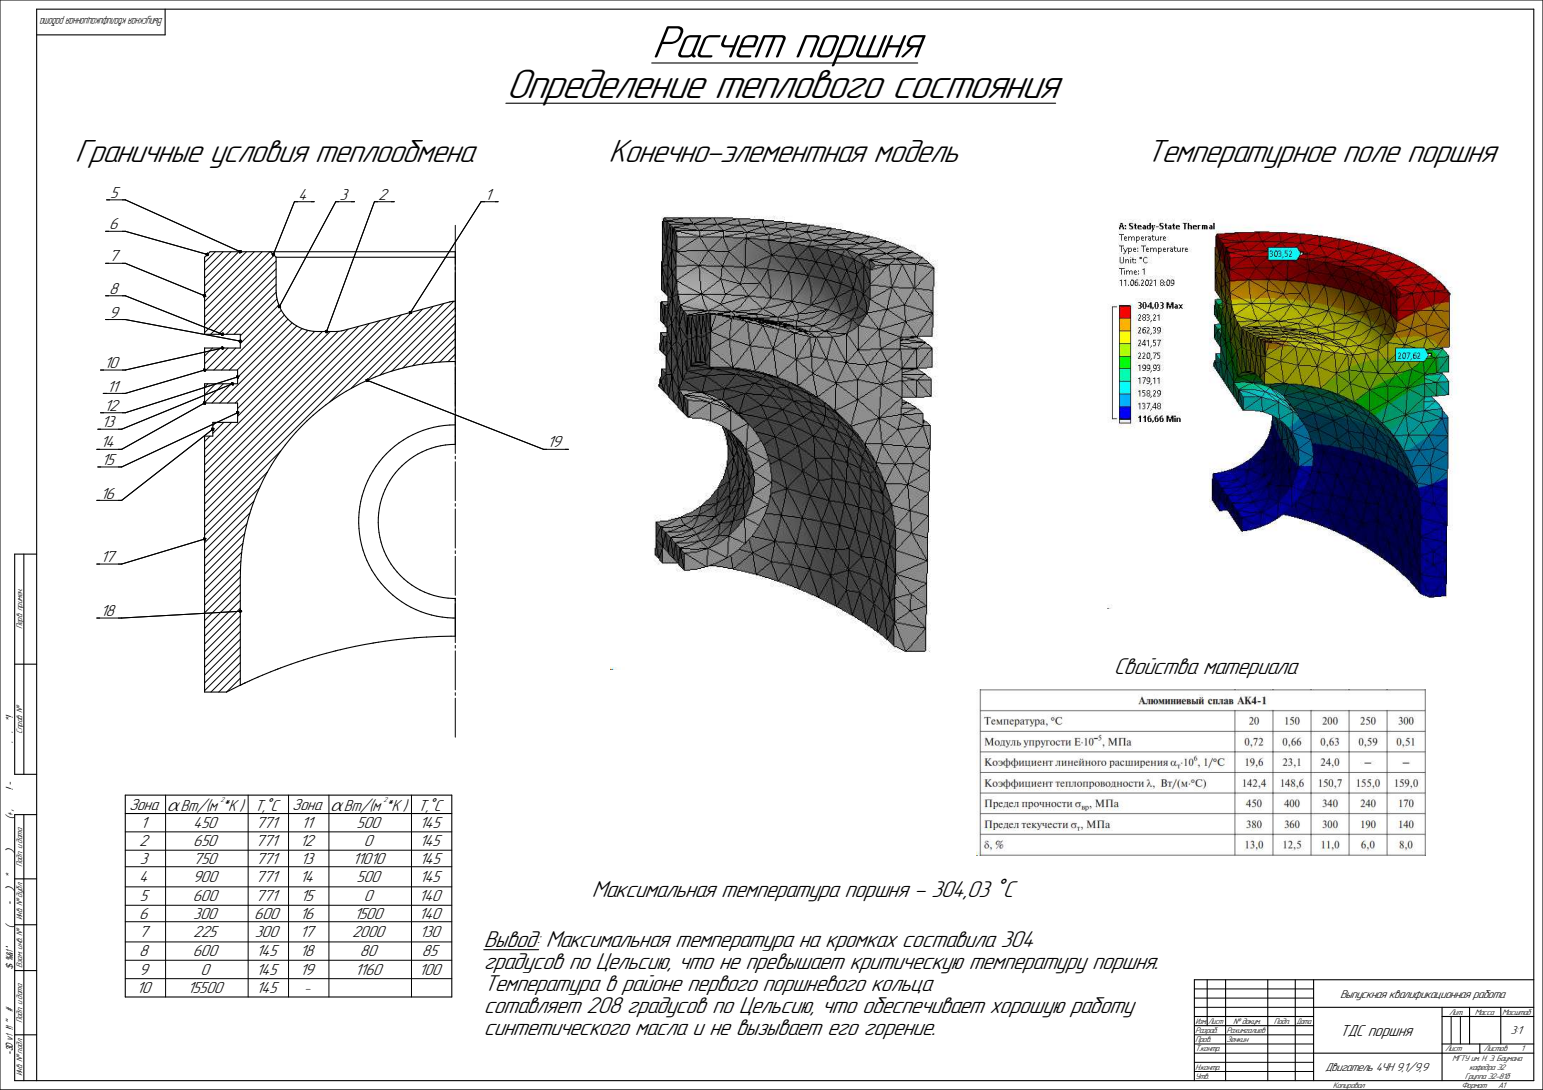
[picture p108: page 10]
Ìàêñèìàëüíàÿ òåìïåðàòóðà ïîðøíÿ - 304,03 ÅÑ; Ñâîéñòâà ìàòåðèàëà; Ãðàíè÷íûå óñëîâèÿ òåïëîîáìåíà; Êîíå÷íî-ýëåìåíòíàÿ ìîäåëü; Òåìïåðàòóðíîå ïîëå ïîðøíÿ; Äâèãàòåëü 4×Í 9,1/9,9; Ãðóïïà Ý2-81á

Ðàñ÷åò ïîðøíÿ

Îïðåäåëåíèå òåïëîâîãî ñîñòîÿíèÿ

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

КОМПАС-3D v18.1 Учебная версия © 2019 ООО "АСКОН-Системы проектирования", Россия. Все права защищены.

Çîíà αÂò/(ì²*Ê ) | | Ò,ÅÑ | Çîíà αÂò/(ì²*Ê ) | | Ò,ÅÑ
1 | 450 | 771 | 11 | 500 | 145
2 | 650 | 771 | 12 | 0 | 145
3 | 750 | 771 | 13 | 11010 | 145
4 | 900 | 771 | 14 | 500 | 145
5 | 600 | 771 | 15 | 0 | 140
6 | 300 | 600 | 16 | 1500 | 140
7 | 225 | 300 | 17 | 2000 | 130
8 | 600 | 145 | 18 | 80 | 85
9 | 0 | 145 | 19 | 1160 | 100

Ìàêñèìàëüíàÿ òåìïåðàòóðà ïîðøíÿ - 304,03 ÅÑ

Âûâîä: Ìàêñèìàëüíàÿ òåìïåðàòóðà íà êðîìêàõ ñîñòàâèëà 304
ãðàäóñîâ ïî Öåëüñèþ, ÷òî íå ïðåâûøàåò êðèòè÷åñêóþ òåìïåðàòóðó ïîðøíÿ.
Òåìïåðàòóðà â ðàéîíå ïåðâîãî ïîðøíåâîãî êîëüöà
ñîòàâëÿåò 208 ãðàäóñîâ ïî Öåëüñèþ, ÷òî îáåñïå÷èâàåò õîðîøóþ ðàáîòó
ñèíòåòè÷åñêîãî ìàñëà è íå âûçûâàåò åãî ãîðåíèå.

Âûïóñêíàÿ êâàëèôèêàöèîííàÿ ðàáîòà

Ëèò. | Ìàññà | Ìàñøòàá

Èçì. Ëèñò | ¹ äîêóì. | Ïîäï. | Äàòà | | | | | 3:1
Ðàçðàá. | Ðàõèìãàëèåâ | | | ÒÄÑ ïîðøíÿ Çåíêèí

Çàäàíèå ìíîæåñòâà âîçìîæíûõ ðåøåíèé; Ñðàâíåíèå ìåòîäèê ïîäáîðà êëàïàííûõ ïðóæèí; Îïðåäåëåíèå çàêîíà äâèæåíèÿ êëàïàíà; Îïðåäåëåíèå ìàññû ïîäâèæíûõ äåòàëåé ÃÁÖ; Îïðåäåëåíèå ïðèæèìíîé ñèëû êëàïàíà; Êëàññè÷åñêèõ àëãîðèòì ïîäáîðà êëàïàííûõ ïðóæèí; Ìåòîäèêà ïîäáîðà êëàïàííîé ïðóæèíû íà îñíîâå ïàðåòî- îïòèìàëüíîñòè êðèòåðèåâ; Ïîäáîð ãåîìåòðè÷åñêèõ ïàðàìåòðîâ ïðóæèíû; Ïðîâåðêà êîýô. çàïàñà; - Çàäàíèå íà÷àëüíûõ óñëîâèé:; 1) ïðèæèìíàÿ ñèëà 2) ôèçè÷åñêèå ñâîéñòâà ïðóæèíû; Çàäàíèå öåëåâûõ ôóíêöèé: 1) äëèíà ïðóæèíû â ñæàòîì ñîñòîÿíèè 2) êîýôôèöèåíò çàïàñà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

ïî êàñàòåëüíîìó íàïð. Ïðîâåðêà íà ðåçîíàíñ ïî êàñàòåëüíîìó íàïð. Ïðîâåðêà íà ðåçîíàíñ

КОМПАС-3D v18.1 Учебная версия © 2019 ООО "АСКОН-Системы проектирования", Россия. Все права защищены.

Ïàðåòî-ôðîíò îïòèìàëüíûõ ïàðàìåòðîâ êëàïàííîé ïðóæèíû ñ îãðàíè÷åíèì äèàìåòðà íàâèâêè ïðóæèíû d < 26 ìì

* Ñèíèì öâåòîì îáîçíà÷åíû âîçìîæíûå ðåøåíèÿ * Êðàñíûì - ôðîíò Ïàðåòî
* ×åðíûì - âûáðàííàÿ ïðóæèíà

Ðèñóíîê 3 - çàâèñèìîñòü êîëè÷åñòâà ðàáî÷èõ âèòêîâ îò êîýôôèöèåíòà çàïàñà

Ðèñóíîê 1 - çàâèñèìîñòü äëèíû ïðóæèíû â ñæàòîì ñîñòîÿíèè îò êîýôôèöèåíòà çàïàñà

Ðèñóíîê 2 - çàâèñèìîñòü ñðåäíåãî äèàìåòðà ïðóæèíû îò êîýôôèöèåíòà çàïàñà

Ïàðåòî-ôðîíò îïòèìàëüíûõ ïàðàìåòðîâ êëàïàííîé ïðóæèíû ñ îãðàíè÷åíèì äèàìåòðà íàâèâêè ïðóæèíû d < 26 ìì

* Ñèíèì öâåòîì îáîçíà÷åíû âîçìîæíûå ðåøåíèÿ * Êðàñíûì - ôðîíò Ïàðåòî
* ×åðíûì - âûáðàííàÿ ïðóæèíà

Ðèñóíîê 3 - çàâèñèìîñòü êîëè÷åñòâà ðàáî÷èõ âèòêîâ îò êîýôôèöèåíòà çàïàñà

Ðèñóíîê 1 - çàâèñèìîñòü äëèíû ïðóæèíû â ñæàòîì ñîñòîÿíèè îò êîýôôèöèåíòà çàïàñà

Ðèñóíîê 2 - çàâèñèìîñòü ñðåäíåãî äèàìåòðà ïðóæèíû îò êîýôôèöèåíòà çàïàñà

КОМПАС-3D v18.1 Учебная версия © 2019 ООО "АСКОН-Системы проектирования", Россия. Все права защищены.


Ïàðåòî-ôðîíò îïòèìàëüíûõ ïàðàìåòðîâ êëàïàííîé ïðóæèíû

Ðèñóíîê 3 - Çàâèñèìîñòü êîëè÷åñòâà ðàáî÷èõ âèòêîâ îò êîýôôèöèåíòà çàïàñà

Ðèñóíîê 1 - Çàâèñèìîñòü äëèíû ïðóæèíû â ñæàòîì ñîñòîÿíèè îò êîýôôèöèåíòà çàïàñà

Ðèñóíîê 2 - Çàâèñèìîñòü ñðåäíåãî äèàìåòðà ïðóæèíû îò êîýôôèöèåíòà çàïàñà

Òàáëèöà 1 - Ðåçóëüòàòû ñðàâíåíèÿ ïðóæèí

Ïàðåòî-ôðîíò îïòèìàëüíûõ ïàðàìåòðîâ êëàïàííîé ïðóæèíû

Ðèñóíîê 3 - Çàâèñèìîñòü êîëè÷åñòâà ðàáî÷èõ âèòêîâ îò êîýôôèöèåíòà çàïàñà

Ðèñóíîê 1 - Çàâèñèìîñòü äëèíû ïðóæèíû â ñæàòîì ñîñòîÿíèè îò êîýôôèöèåíòà çàïàñà

Ðèñóíîê 2 - Çàâèñèìîñòü ñðåäíåãî äèàìåòðà ïðóæèíû îò êîýôôèöèåíòà çàïàñà

Òàáëèöà 1 - Ðåçóëüòàòû ñðàâíåíèÿ ïðóæèí

КОМПАС-3D v18.1 Учебная версия © 2019 ООО "АСКОН-Системы проектирования", Россия. Все права защищены.

ЗАКЛЮЧЕНИЕ

Таким образом, спроектирован поршневой ДВС для автомобиля. Можно отметить основные выводы:

1. Была получена математическая модель рабочего процесса двигателя с помощью ПК «Дизель-РК»
2. Был выполнен эскизный проект разработанного двигателя: поперечный и продольные разрезы.
3. Был разработан сборочный чертеж детали балансирного вала
4. Была разработана твердотельная трехмерная модель сборки шатунно-поршневой группы, коленвала и балансирных валов.
5. С помощью ПК «ANSYS» и ПК «KVAL» были проведены расчеты основных деталей КШМ двигателя: расчет теплового состояния поршня, расчет поршневого пальца, расчет шатуна, расчет коленчатого вала. Расчеты показали работоспособность всех деталей в рамках рассматриваемых условий.
6. Разработана методика проектирования клапанных пружин на основе многокритериальной оценки. Оптимизирована клапанная пружина методом построения фронта Парето. В результате оптимизации удалось добиться уменьшения габаритов головки блоков цилиндров с незначительным уменьшением коэффициента запаса пружины.
