rakhimgaliyev/vkrb/на печать/2_А2_ЧБ_ЛИСТ_2.pdf

596

Ìàññà Ìàñøòàá; Èçì. Ëèñò ¹ äîêóì.; Ïîäï. Äàòà; Ëèò.; Ðàçðàá. Ïðîâ.; Ò.êîíòð.; Ëèñò; Ëèñòîâ; Í.êîíòð. Óòâ.; Ðàõèìãàëèåâ; Äâèãàòåëü 4×Í 9,1/9,9; Çåíêèí; Êîïèðîâàë

Âûïóñêíàÿ êâàëèôèêàöèîííàÿ ðàáîòà

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

КОМПАС-3D v18.1 Учебная версия © 2019 ООО "АСКОН-Системы проектирования", Россия. Все права защищены.

ÌÃÒÓ èì. Í. Ý. Áàóìàíà
êàôåäðà Ý2
ãðóïïà Ý2-81Á
Ôîðìàò

ïîïåðå÷íûé ðàçðåç

Не для коммерческого использования
