rakhimgaliyev/vkrb/(commit log)

2021-05-05 че скоро первый лист ебнем
2021-05-26 лист с ансисом коленвала
2021-06-06 нир оформил
    [гидрокомпенсатор.SLDPRT, клапан.SLDPRT, кулачек.SLDPRT]
2021-06-08 шатун и палец
2021-06-11 че шатун нормально эи есть с поршнем
    [piston.dwg, piston.idw, piston.igs, piston.ipt]
2021-06-16 сборку сделал
    [connecting_rod.ipt, crankshaft.0019.ipt, crankshaft.ipt, pin.ipt, piston.ipt, Зубчатый ремень1.ipt, Зубчатый ремень2.ipt, Зубчатый ремень3.ipt]
2021-06-16 подготовил первые листы на печать (1, 2 нужно править)
    [balancing_scheme.0016.dwg, balancing_scheme.dwg, Сборка-1.0002.dwg, Сборка-1.0003.dwg, Сборка-1.dwg, сборка_балансирного_вала.0001.iam, сборка_балансирного_вала.0002.iam, сборка_балансирного_вала.iam]
2021-06-16 поправил все листы, кроме 1 и 2
    [balancing_scheme.0016.dwg, balancing_scheme.0018.dwg, balancing_scheme.dwg, Зубчатый ремень6.ipt, Зубчатый ремень7.ipt, Зубчатый ремень8.ipt, Зубчатый ремень9.ipt, Передача с помощью зубчатых ремней6.iam]
2021-06-16 lil fix
    [Сборка-1.0006.dwg, Сборка-1.0007.dwg, Сборка-1.dwg]
2021-06-17 исправил
2021-06-21 рпз бахнул
    [balancing_scheme.0018.dwg, balancing_scheme.0019.dwg, balancing_scheme.dwg]
